Crann-Data/speeduino-hardware/v0.4-mini/Interface boards/48 Pin NA Miata/NA Miata 48 pin_schem.png

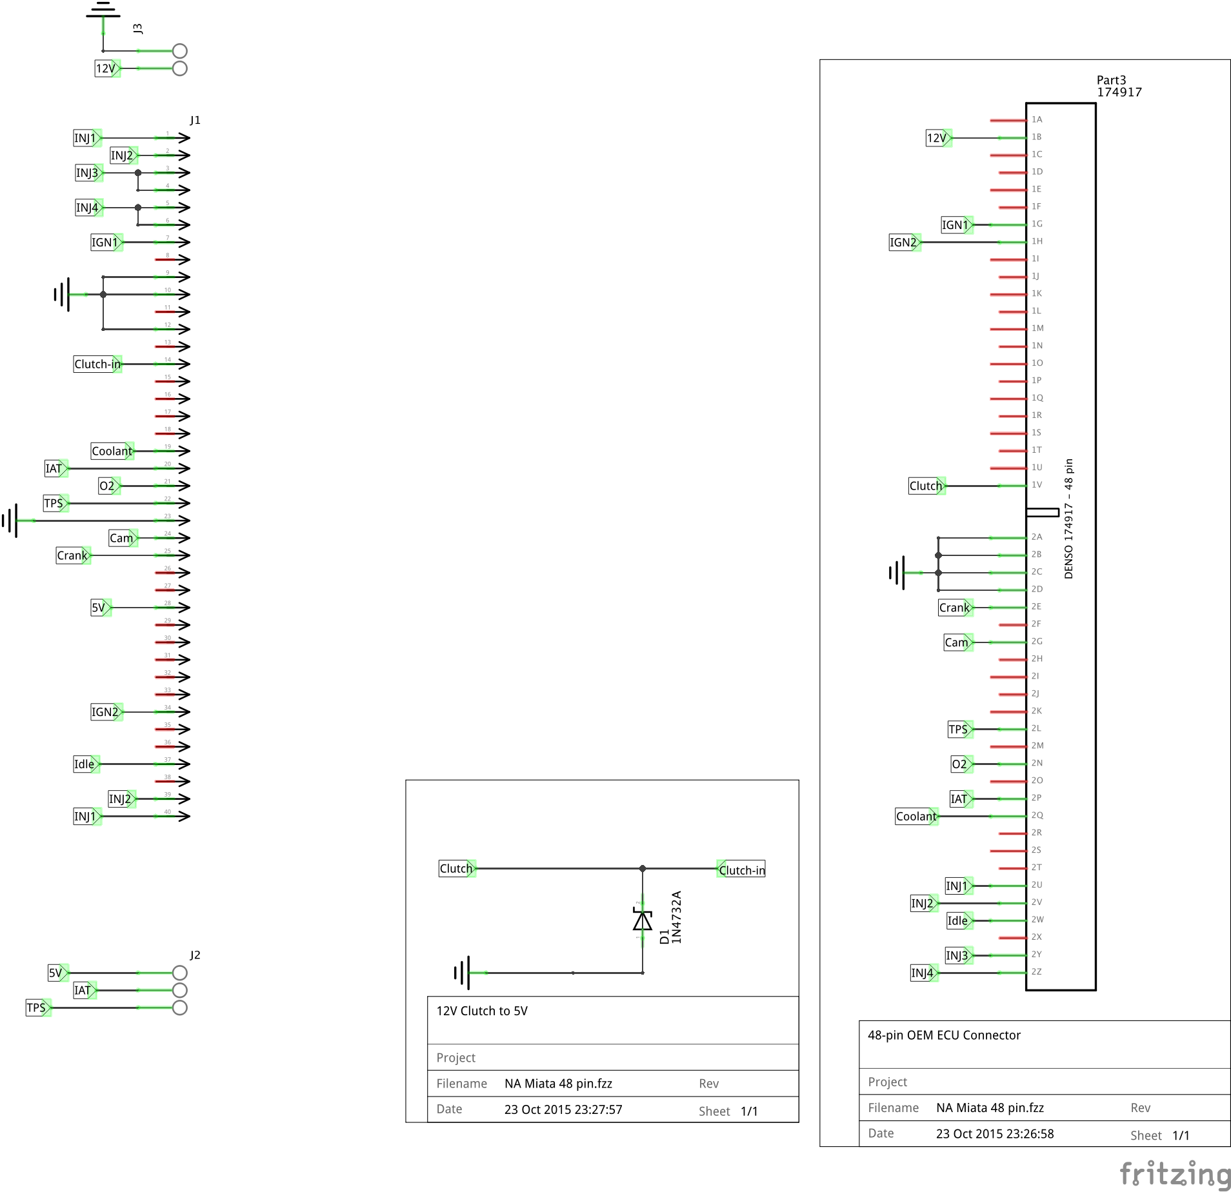
v0.4-mini/Interface boards/48 Pin NA Miata/NA Miata 48 pin_schem.png
