Crann-Data/speeduino-hardware/v0.4-mini/THT/Prior versions/v0.4.3/schematic v0.4.3_schem.png

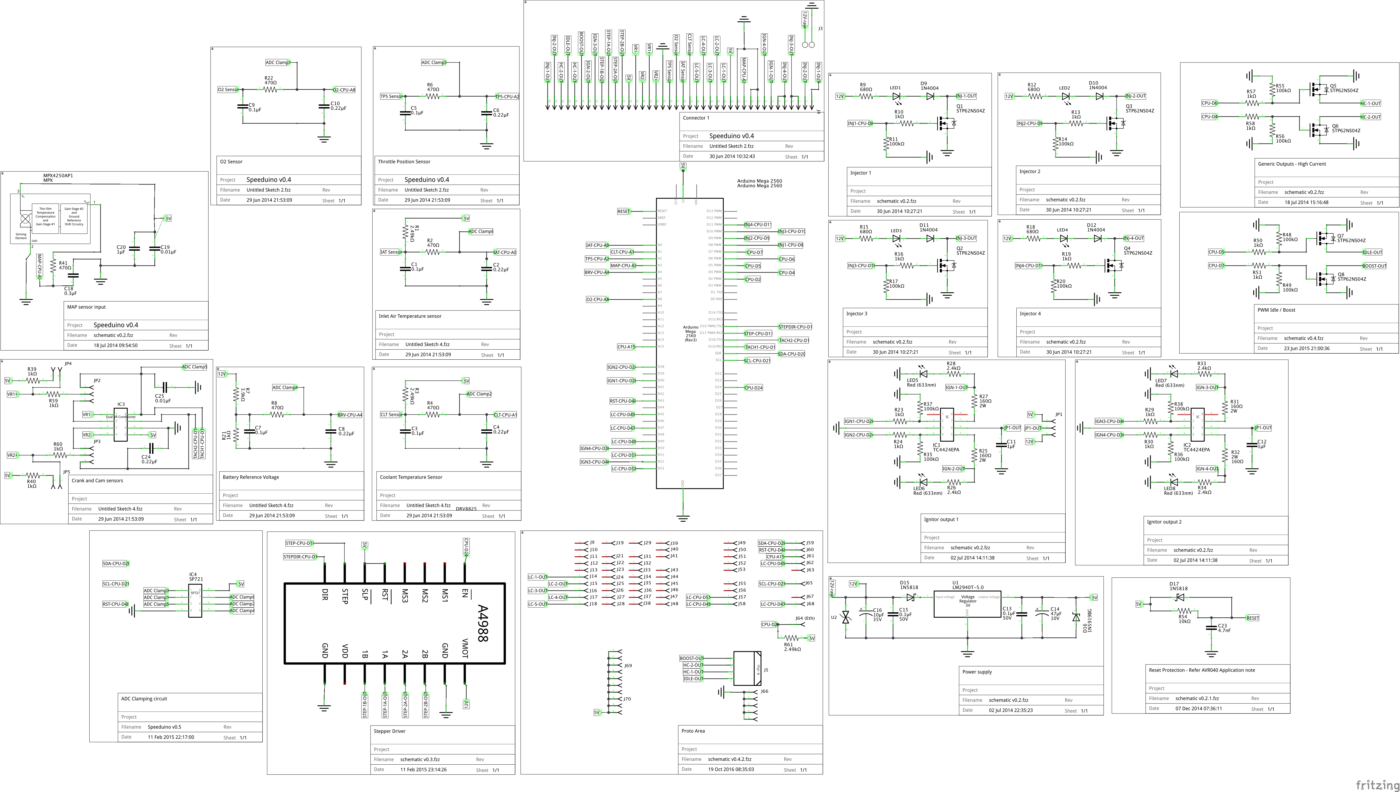
v0.4-mini/THT/Prior versions/v0.4.3/schematic v0.4.3_schem.png
