Crann-Data/speeduino-hardware/v0.4-mini/THT/Prior versions/v0.4.3/Speeduino_v04_notes.png

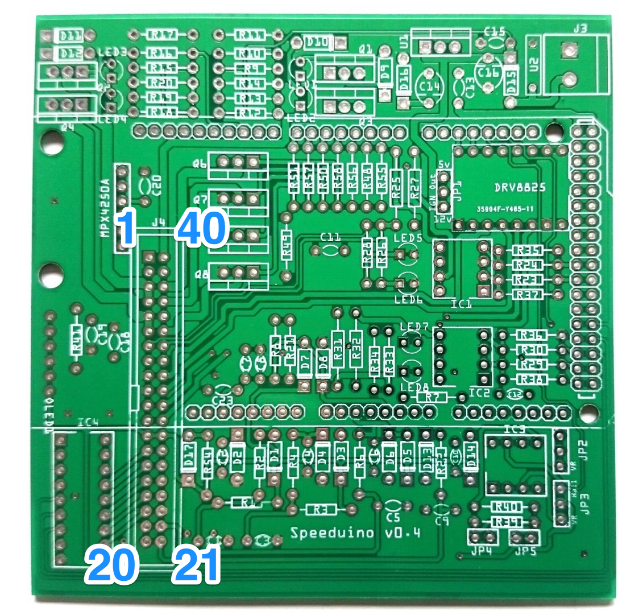
v0.4-mini/THT/Prior versions/v0.4.3/Speeduino_v04_notes.png
