Crann-Data/speeduino-hardware/v0.4-mini/THT/Latest/v0.4.3d BOM.xlsx

 | Speeduino BOM |  |  | v0.4.3d
Reference | Quantity | Value | Manufacturer_Name | Manufacturer_Part_Number | Footprint | URL | Digikey Part Number | Digikey BOM import
A1 | 2 | DRV8825 socket | Sullins | PPTC081LFBN-RC | Module:Pololu_Breakout-16_15.2x20.3mm | https://www.digikey.com.au/products/en?keywords=PPTC081LFBN-RC | S7006-ND | 2,S7006-ND
C1 C15 | 2 | 0.01uF | TDK | FA18X7R1H103KNU06 | Capacitor_THT:C_Disc_D5.0mm_W2.5mm_P2.50mm | https://www.digikey.com.au/product-detail/en/tdk-corporation/FA18X7R1H103KNU06/445-174244-1-ND/5865002 | 445-174244-1-ND | 2,445-174244-1-ND
C17 | 1 | 10uF | Panasonic | EEU-FC1H100L | Capacitor_THT:CP_Radial_D5.0mm_P2.00mm | https://www.digikey.com.au/product-detail/en/panasonic-electronic-components/EEU-FC1H100L/P10316-ND/266325 | P10316-ND | 1,P10316-ND
C19 | 1 | 22uF | TDK | FA22X7R1E226MRU06 | Capacitor_THT:C_Disc_D7.5mm_W5.0mm_P5.00mm |  | 445-180603-1-ND | 1,445-180603-1-ND
C21 | 1 | 47uF | Panasonic | EEU-FC1H470B | Capacitor_THT:CP_Radial_D8.0mm_P5.00mm |  | P19658CT-ND | 1,P19658CT-ND
C3 C4 C9 C10 C11 C16 C18 C20 C22 C23 C24 C28 | 12 | 0.1uF | TDK | FA18X8R1E104KNU06 | Capacitor_THT:C_Disc_D5.0mm_W2.5mm_P2.50mm | https://www.digikey.com.au/product-detail/en/tdk-corporation/FA18X8R1E104KNU06/445-180563-1-ND/9560689 | 445-180563-1-ND | 12,445-180563-1-ND
C2 C25 | 2 | 1uF | TDK | FA18X7R1E105KRU06 | Capacitor_THT:C_Disc_D5.0mm_W2.5mm_P2.50mm | https://www.digikey.com.au/product-detail/en/tdk-corporation/FA18X7R1E105KRU06/445-180543-1-ND/9560669 | 445-180543-1-ND | 2,445-180543-1-ND
C5 C6 C7 C12 C13 C14 | 6 | 0.22uF | TDK | FA18X8R1E224KRU06 | Capacitor_THT:C_Disc_D5.0mm_W2.5mm_P2.50mm | https://www.digikey.com.au/product-detail/en/tdk-corporation/FA18X8R1E224KRU06/445-180564-1-ND/9560690 | 445-180564-1-ND | 6,445-180564-1-ND
C8 C29 | 2 | 470pf | TDK | FA18NP01H471JNU06 | Capacitor_THT:C_Disc_D5.0mm_W2.5mm_P2.50mm | https://www.digikey.com.au/product-detail/en/tdk-corporation/FA18NP01H471JNU06/445-180522-1-ND/9560648 | 445-180522-1-ND | 2,445-180522-1-ND
D5 D6 D11 D12 D13 D16 | 6 | Diode - General purpose | Vishay | 1N914TAP | Diode_THT:D_DO-35_SOD27_P7.62mm_Horizontal | https://www.digikey.com.au/product-detail/en/vishay-general-semiconductor-diodes-division/1N914TAP/1N914TAPGICT-ND/8564478 | 1N914TAPGICT-ND | 6,1N914TAPGICT-ND
D14 | 1 | SB230TA | SMC | SB230TA | Diode_THT:D_DO-41_SOD81_P7.62mm_Horizontal | https://www.digikey.com.au/product-detail/en/smc-diode-solutions/SB230TA/1655-1518-1-ND/6022963 | 1655-1518-1-ND | 1,1655-1518-1-ND
D15 | 1 | D_TVS | Littelfuse | TP6KE47A | Diode_THT:D_DO-15_P12.70mm_Horizontal |  | F6853CT-ND | 1,F6853CT-ND
D1 D2 D3 D4 D7 D8 D9 D10 | 8 | LED | Wurth | 151031SS04000 | LED_THT:LED_D3.0mm | https://www.digikey.com.au/product-detail/en/w%C3%BCrth-elektronik/151031SS04000/732-5005-ND/4489979 | 732-5005-ND | 8,732-5005-ND
F1 F2 | 2 | Polyfuse | Bel Fuse | 0ZRP0050FF1E | Fuse:Fuse_BelFuse_0ZRE0055FF_L14.0mm_W4.1mm | https://www.digikey.com.au/product-detail/en/bel-fuse-inc/0ZRP0050FF1E/507-2403-ND/9468252 | 507-2403-ND | 2,507-2403-ND
IC3 | 2 | Trig Cond Socket | Sullins Connector Solutions | PPTC041LFBN-RC | Package_DIP:DIP-8_W7.62mm_Socket |  | S7002-ND | 2,S7002-ND
J4 | 1 | Conn_02x20_Counter_Clockwise | Sullins | SBH11-PBPC-D20-ST-BK | Connector_IDC:IDC-Header_2x20_P2.54mm_Vertical | https://www.digikey.com.au/product-detail/en/sullins-connector-solutions/SBH11-PBPC-D20-ST-BK/S9175-ND/1990068 | S9175-ND | 1,S9175-ND
Q1 Q2 Q3 Q4 | 4 | N-Channel MOSFET | ST | STP62NS04Z | Package_TO_SOT_THT:TO-220-3_Horizontal_TabDown |  | 497-5896-5-ND | 4,497-5896-5-ND
Q5 Q6 | 2 | Q_NMOS_GDSD | Vishay | IRLD024PBF | Package_DIP:Vishay_HVM-DIP-3_W7.62mm | https://www.digikey.com.au/product-detail/en/vishay-siliconix/IRLD024PBF/IRLD024PBF-ND/812492 | IRLD024PBF-ND | 2,IRLD024PBF-ND
R1 R2 R3 R4 R13 R14 R15 R16 R19 R20 R28 R43 | 12 | 100k | Vishay | MBA02040C1003FCT00 | Resistor_THT:R_Axial_DIN0204_L3.6mm_D1.6mm_P5.08mm_Horizontal | https://www.digikey.com.au/product-detail/en/vishay-beyschlag-draloric-bc-components/MBA02040C1003FCT00/BC3240CT-ND/6138743 | BC3240CT-ND | 12,BC3240CT-ND
R9 R10 R11 R12 R23 R24 R25 R26 R33 | 9 | 2.4k | Vishay | MBA02040C2401FC100 | Resistor_THT:R_Axial_DIN0204_L3.6mm_D1.6mm_P5.08mm_Horizontal | https://www.digikey.com.au/product-detail/en/vishay-beyschlag-draloric-bc-components/MBA02040C2401FC100/BC3483CT-ND/7350913 | BC3483CT-ND | 9,BC3483CT-ND
R30 | 1 | 3.9k | Vishay | MBA02040C3901FCT00 | Resistor_THT:R_Axial_DIN0204_L3.6mm_D1.6mm_P5.08mm_Horizontal | https://www.digikey.com.au/product-detail/en/vishay-beyschlag-draloric-bc-components/MBA02040C3901FCT00/BC3272CT-ND/6138775 | BC3272CT-ND | 1,BC3272CT-ND
R31 R32 R34 R38 R39 R40 R55 R62 R63 | 9 | 470R | Vishay | MBA02040C4700FRP00 | Resistor_THT:R_Axial_DIN0204_L3.6mm_D1.6mm_P5.08mm_Horizontal | https://www.digikey.com.au/product-detail/en/vishay-beyschlag-draloric-bc-components/MBA02040C4700FRP00/BC3516CT-ND/7350946 | BC3516CT-ND | 9,BC3516CT-ND
R35 R36 | 2 | 2.49k | Vishay | MBA02040C2491FRP00 | Resistor_THT:R_Axial_DIN0204_L3.6mm_D1.6mm_P5.08mm_Horizontal | https://www.digikey.com.au/product-detail/en/vishay-beyschlag-draloric-bc-components/MBA02040C2491FRP00/BC2-49KXCT-ND/336807 | BC2.49KXCT-ND | 2,BC2.49KXCT-ND
R27 R45 | 2 | 10k | Vishay | MBA02040C1002FRP00 | Resistor_THT:R_Axial_DIN0204_L3.6mm_D1.6mm_P5.08mm_Horizontal | https://www.digikey.com.au/product-detail/en/vishay-beyschlag-draloric-bc-components/MBA02040C1002FRP00/BC10-0KXCT-ND/336866 | BC10.0KXCT-ND | 2,BC10.0KXCT-ND
R46 | 1 | 120R | Vishay | MBA02040C1200FC100 | Resistor_THT:R_Axial_DIN0204_L3.6mm_D1.6mm_P5.08mm_Horizontal |  | BC3453CT-ND | 1,BC3453CT-ND
R5 R6 R7 R8 R17 R18 R21 R22 R29 R37 R41 R42 R44 R47 R53 R54 | 16 | 1k | Vishay | MBA02040C1001FRP00 | Resistor_THT:R_Axial_DIN0204_L3.6mm_D1.6mm_P5.08mm_Horizontal |  | BC1.00KXCT-ND | 16,BC1.00KXCT-ND
R52 | 1 | 2k | Vishay | MBA02040C2001FCT00 | Resistor_THT:R_Axial_DIN0204_L3.6mm_D1.6mm_P5.08mm_Horizontal | https://www.digikey.com.au/product-detail/en/vishay-beyschlag-draloric-bc-components/MBA02040C2001FCT00/BC3254CT-ND/6138757 | BC3254CT-ND | 1,BC3254CT-ND
U1 U3 | 2 | SP721 | Littelfuse | SP721APP | Package_DIP:DIP-8_W7.62mm |  | F2720-ND | 2,F2720-ND
U2 U4 | 2 | TC4424A | Microchip | TC4424AVPA | Package_DIP:DIP-8_W7.62mm_Socket | https://www.digikey.com.au/product-detail/en/microchip-technology/TC4424AVPA/TC4424AVPA-ND/1098910 | TC4424AVPA-ND | 2,TC4424AVPA-ND
U5 | 1 | MPX4250 | NXP | MPX4250AP | Misc:MPX4250 | https://www.digikey.com.au/product-detail/en/nxp-usa-inc/MPX4250AP/MPX4250AP-ND/464053 | MPX4250AP-ND | 1,MPX4250AP-ND
U6 | 1 | ULN2003 | TI | ULN2003AIN‎ | Package_DIP:DIP-16_W7.62mm | https://www.digikey.com.au/product-detail/en/texas-instruments/ULN2003AIN/296-16971-5-ND/653041 | 296-16971-5-ND | 1,296-16971-5-ND
U8 | 1 | LM2940S-5.0 | ON Semi | NCV7805BTG | Package_TO_SOT_THT:TO-220-3_Horizontal_TabDown | https://www.digikey.com.au/product-detail/en/on-semiconductor/NCV7805BTG/NCV7805BTGOS-ND/921437 | NCV7805BTGOS-ND | 1,NCV7805BTGOS-ND
