Crann-Data/speeduino-hardware/v0.4-mini/THT/Prior versions/v0.4.3/v0.4.3_bom.xlsx

QTY Full | Board Reference Full | Value | Type | Information | Included | Manufacturer | Model# | Digikey P/N | Mouser P/N | Digikey Price (USD) | Mouser Price (USD) | CTM Full Digikey | CTM Full Mouser | CTM 2 Ch Digikey | CTM 2 Ch Mouser | Note | Full Digikey import | 2Ch Digikey import | General Description | Mouser Full
 |  |  |  |  |  |  |  |  |  |  |  |  |  |  |  |  |  |  | x
1 | C16 | 10uF | CAP TANT 10UF 35V 10% RADIAL | Tantalum |  | Kemet | T356G106K035AT | 399-3654-ND (http://www.digikey.com/product-detail/en/TAP106K035SCS/478-1842-ND/563945) | 80-T356G106K035AT | $1.70 | $1.70 | $1.70 | $1.70 | $1.70 | $1.70 |  | 1,399-3654-ND | 1,399-3654-ND | Capacitor - 1x 10uF | 80-T356G106K035AT|1 | T356G106K035AT 1
6 | C2,C4,C6,C8,C10,C24 | 0.22uF | CAP CER 0.22UF 50V 10% RADIAL | X7R |  | Kemet | K224K20X7RF5UH5 | BC2678CT-ND | 594-K224K20X7RF5UH5 | $0.66 | $0.66 | $3.96 | $3.96 | $3.96 | $3.96 |  | 6,BC2678CT-ND | 6,BC2678CT-ND | Capacitor - 6x 0.22uF | 594-K224K20X7RF5UH5|6 | K224K20X7RF5UH5 6
7 | C1,C3,C5,C7,C9,C13,C15 | 0.1uF / 100nF | CAP CER 0.1UF 50V 20% RADIAL | X7R |  | Vishay | K104K15X7RF53H5 | BC3323-ND | 80-C322C104M5R-TR | $0.36 | $0.32 | $2.52 | $2.24 | $2.52 | $2.24 |  | 7,BC3323-ND | 7,BC3323-ND | Capacitor - 7x 0.1uF / 100nF | 80-C322C104M5R-TR|7 | K104K15X7RF53H5 7
1 | C14 | 47uF | CAP TANT 47UF 6.3V 10% RADIAL | Tantalum |  | Kemet | T356F476K006AT | 399-3652-ND (http://search.digikey.com/us/en/products/TAP476K010SCS/478-1910-ND/564013) | 80-T356F476K6AT | $1.57 | $1.57 | $1.57 | $1.57 | $1.57 | $1.57 |  | 1,399-3652-ND | 1,399-3652-ND | Capacitor - 1x 47uF | 80-T356F476K6AT|1 | T356F476K006AT 1
1 | C18 | 0.33uF | CAP CER 0.33UF 50V 10% RADIAL | X7R |  | AVX Corporation | AR215F334K4R | 478-5120-ND (http://search.digikey.com/us/en/products/FK14X7R1H334K/445-5312-ND/2256792) | 581-AR215F334K4R | $0.62 | $0.43 | $0.62 | $0.43 | $0.62 | $0.43 |  | 1,478-5120-ND | 1,478-5120-ND | Capacitor - 1x 0.33uF | 581-AR215F334K4R|1 | AR215F334K4R 1
2 | C19,C25 | 0.01uF | CAP CER 10000PF 50V 10% RADIAL | X7R |  | Kemet | C317C103K5R5TA | 399-4206-ND (http://www.digikey.com/product-detail/en/C315C103K5R5TA/399-4148-ND/817924) | 80-C317C103K5R | $0.24 | $0.24 | $0.48 | $0.48 | $0.48 | $0.48 |  | 2,399-4206-ND | 2,399-4206-ND | Capacitor - 2x 0.01uF | 80-C317C103K5R|2 | C317C103K5R5TA 2
3 | C11,C12,C20 | 1uF | CAP CER 1UF 50V 20% RADIAL | X7R |  | Kemet | C330C105M5U5TA | 399-4390-ND | 80-C330C105M5U | $0.66 | $0.66 | $1.98 | $1.98 | $1.32 | $1.32 |  | 3,399-4390-ND | 2,399-4390-ND | Capacitor - 3x 1uF | 80-C330C105M5U|3 | C330C105M5U5TA 3
1 | C23 | 4.7nF | CAP CER 4700PF 100V 10% RADIAL | X7R |  | Kemet | C317C472K1R5TA | 399-4243-ND | 80-C317C472K1R | $0.25 | $0.25 | $0.25 | $0.25 | $0.25 | $0.25 |  | 1,399-4243-ND | 1,399-4243-ND | Capacitor - 1x 4.7nF | 80-C317C472K1R|1 | C317C472K1R5TA 1
1 | D16 | 1N5919BG Zener | DIODE ZENER 5.6V 3W AXIAL | DO-41 |  | ON Semiconductor | 1N5919BG | 1N5919BGOS-ND | 863-1N5919BRLG | $0.34 | $0.43 | $0.34 | $0.43 | $0.34 | $0.43 |  | 1,1N5919BGOS-ND | 1,1N5919BGOS-ND | Diode - 1x 1N5919BG Zener | 863-1N5919BRLG|1 | 1N5919BG 1
2 | D15,D17 | 1N5818-TP Schottky | DIODE SCHOTTKY 1A 30V DO41 | DO-41 |  | Micro Commercial Co | 1N5818-TP | 1N5818-TPCT-ND (http://search.digikey.com/us/en/products/1N5818-TP/1N5818-TPCT-ND/950587) | 833-1N5818-TP | $0.39 | $0.39 | $0.78 | $0.78 | $0.78 | $0.78 |  | 2,1N5818-TPCT-ND | 2,1N5818-TPCT-ND | Diode - 2x 1N5818-TP Schottky | 833-1N5818-TP|2 | 1N5818-TP 2
8 | LED1,LED2,LED3,LED4,LED5,LED6,LED7,LED8 | LED-Red | LED SS 3MM 625NM RED DIFF | 5mm-LED |  |  | LTL-4221N | 160-1139-ND | 859-LTL-4221N | $0.47 | $0.10 | $3.76 | $0.80 | $1.88 | $0.40 |  | 8,160-1139-ND | 4,160-1139-ND | Diode - 8x LED-Red | 859-LTL-4221N|8 | LTL-4221N 8
4 | D9,D10,D11,D12 | 1N4004 | DIODE GEN PURPOSE 400V 1A DO41 | DO-41 |  | Micro Commercial Co | 1N4004-TP | 1N4004-TPMSCT-ND | 833-1N4004-TP | $0.11 | $0.11 | $0.44 | $0.44 | $0.22 | $0.22 |  | 4,1N4004-TPMSCT-ND | 2,1N4004-TPMSCT-ND | Diode - 4x 1N4004 | 833-1N4004-TP|4 | 1N4004-TP 4
 |  |  |  |  |  |  |  |  |  |  |  |  |  |  |  |  |  |  | x
1 | U2 | Surge Protection | VARISTOR 22V 3KA DISC 14MM | Disc 14mm |  | Bournes Inc | V14E14AUTO | F6389-ND |  | $0.72 | $0.72 | $0.72 | $0.72 | $0.72 | $0.72 |  | 1,F6389-ND | 1,F6389-ND | 1x Surge Protection |  | V14E14AUTO 1
 |  |  |  |  |  |  |  |  |  |  |  |  |  | $0.00 | $0.00 |  |  |  | x
1 | J3 | Dual Terminal Block | TERMINAL BLOCK 5MM VERT 2POS PCB |  |  | On Shore Technology Inc | OSTTA020161 | ED2561-ND | 571-2828362 | 0.402 | 0.51 | $0.40 | $0.51 | $0.40 | $0.51 | Quite expensive from digikey, cheaper elsewhere | 1,ED2561-ND | 1,ED2561-ND | 1x Dual Terminal Block | 571-2828362|1 | OSTTA020161 1
5 | Jumpers for male pins | Jumper | SHUNT JUMPER .1" BLACK GOLD |  |  |  | 969102-0000-DA | 3M9580-ND | 517-9691020000DA | $0.10 | $0.10 | $0.50 | $0.50 | $0.50 | $0.50 |  | 5,3M9580-ND | 5,3M9580-ND | 5x Jumper | 517-9691020000DA|5 | 969102-0000-DA 5
4 | Male pins | 40 POS 0.100 Pin Header | CONN HEADER .100" SNGL STR 40POS |  |  | Sullins Connector Solutions | PREC040SAAN-RC.. | S1012EC-40-ND | 571-41037410 | $0.56 | $2.95 | $2.24 | $11.80 | $2.24 | $11.80 | Mouser price is crazy | 4,S1012EC-40-ND | 4,S1012EC-40-ND | 4x 40 POS 0.100 Pin Header | 571-41037410|4 | PREC040SAAN-RC.. 4
1 | J4 | Rectangular Connectors - Headers, Male Pins | IDC BOX HEADER .100" 40POS |  |  | CNC Tech | 3020-40-0100-00 | 1175-1614-ND | 571-5103308-8 | $1.13 | $2.00 | $1.13 | $2.00 | $1.13 | $2.00 |  | 1,1175-1614-ND | 1,1175-1614-ND | 1x Rectangular Connectors - Headers, Male Pins | 571-5103308-8|1 | 3020-40-0100-00 1
 |  |  |  |  |  |  |  |  |  |  |  |  |  |  |  |  |  |  | x
8 | Q1,Q2,Q3,Q4,Q5,Q6,Q7,Q8 | 62A MOSFET N-CH | MOSFET N-CH 33V TO-220 | TO-220 |  | STMicroelectronics | STP75NS04Z | 497-5981-5-ND | 511-STP62NS04Z | $1.51 | $1.51 | $12.08 | $12.08 | $9.06 | $9.06 |  | 8,497-5981-5-ND | 6,497-5981-5-ND | 8x 62A MOSFET N-CH | 511-STP62NS04Z|8 | STP75NS04Z 8
1 | R54 | 10k | RES 10.0K OHM 1/4W 1% METAL FILM |  |  | Yageo | MFR-25FBF52-10K | 10.0KXBK-ND (http://search.digikey.com/us/en/products/MFR-25FBF-10K0/10.0KXBK-ND/13219) | 71-RN60D-F-10K | $0.08 | $0.11 | $0.08 | $0.11 | $0.08 | $0.11 |  | 1,10.0KXBK-ND | 1,10.0KXBK-ND | Resistor - 1x 10k | 71-RN60D-F-10K|1 | MFR-25FBF52-10K 1
17 | R10,R13,R16,R19,R21,R23,R24,R29,R30,R39,R40,R50,R51,R57,R58,R59,R60 | 1k | RES 1.00K OHM 1/4W 1% METAL FILM |  |  | Yageo | MFR-25FBF52-1K | 1.00KXBK-ND | 71-RN60D-F-1.0K | $0.06 | $0.11 | $1.02 | $1.87 | $0.78 | $1.43 |  | 17,1.00KXBK-ND | 13,1.00KXBK-ND | Resistor - 17x 1k | 71-RN60D-F-1.0K|17 | MFR-25FBF52-1K 17
4 | R9,R12,R15,R18 | 680 | RES 680 OHM 0.6W 1% AXIAL |  |  | TE Connectivity | 1622545-1 | A105963CT-ND | 279-LR1F680R | $0.22 | $0.15 | $0.88 | $0.60 | $0.44 | $0.30 | LED current limiting resistors | 4,A105963CT-ND | 2,A105963CT-ND | Resistor - 4x 680 | 279-LR1F680R|4 | 1622545-1 4
6 | R2,R4,R6,R8,R22,R41 | 470 | RES METAL FILM 1/4W 470 OHM 1% AXIAL |  |  | Stackpole Electronics Inc | RNF14FTD470R | RNF14FTD470RCT-ND | 279-LR1F470R | $0.11 | $0.15 | $0.66 | $0.90 | $0.66 | $0.90 |  | 6,RNF14FTD470RCT-ND | 6,RNF14FTD470RCT-ND | Resistor - 6x 470 | 279-LR1F470R|6 | RNF14FTD470R 6
7 | R1,R3,R26,R28,R33,R34,R61 | 1% 2.49k | 2.49k Ohm ±1% 0.25W, 1/4W Through Hole Resistor Axial Metal Film | For GM Sensors |  | Yageo | MFR-25FBF52-2K49 | 2.49KXBK-ND (http://search.digikey.com/us/en/products/RC55Y-2K49BI/985-1047-1-ND/2401912) | 603-MFR-25FBF52-2K49 | $0.14 | $0.16 | $0.98 | $1.12 | $0.70 | $0.80 |  | 7,2.49KXBK-ND | 5,2.49KXBK-ND | Resistor - 7x 1% 2.49k | 603-MFR-25FBF52-2K49|7 | MFR-25FBF52-2K49 7
1 | R7 | 0.1% 3.9k | RES 3.9K OHM 1/4W 0.1% METAL FILM AXL |  |  | Yageo | MFP-25BRD52-3K9 | 3.9KADCT-ND (http://search.digikey.com/us/en/products/MFP-25BRD52-3K9/3.9KADCT-ND/2059137) | 279-H83K9BDA | $0.46 | $1.10 | $0.46 | $1.10 | $0.46 | $1.10 | Battery reference (Voltage divider) | 1,3.9KADCT-ND | 1,3.9KADCT-ND | Resistor - 1x 0.1% 3.9k | 279-H83K9BDA|1 | MFP-25BRD52-3K9 1
12 | R11,R14,R17,R20,R35,R36,R37,R38,R48,R49,R55,R56 | 100k | RES 100K OHM 1/4W 1% METAL FILM |  |  | Yageo | MFR-25FBF52-100K | 100KXBK-ND (http://search.digikey.com/us/en/products/MFR-25FBF-100K/100KXBK-ND/13473) | 603-FMF-25FTF52100K | $0.10 | $0.10 | $1.20 | $1.20 | $0.80 | $0.80 |  | 12,100KXBK-ND | 8,100KXBK-ND | Resistor - 12x 100k | 603-FMF-25FTF52100K|12 | MFR-25FBF52-100K 12
4 | R25,R27,R31,R32 | 160 | RES 10 OHM 2W 5% AXIAL |  |  | Yageo | FMP200JR-52-10R | 10ZCT-ND |  | $0.27 | $0.23 | $1.08 | $0.92 | $0.54 | $0.46 |  | 4,10ZCT-ND | 2,10ZCT-ND | Resistor - 4x 160 |  | FMP200JR-52-10R 4
1 | U1 | LM2940T-5.0/NOPB | IC REGULATOR LDO LM2940-5.0 1A TO220 | TO-220 |  | Texas Instruments | LM2940T-5.0/NOPB | LM2940T-5.0/NOPB | 926-LM2940T-5.0/NOPB | $1.68 | $1.67 | $1.68 | $1.67 | $1.68 | $1.67 |  | 1,LM2940T-5.0/NOPB | 1,LM2940T-5.0/NOPB | 1x LM2940T-5.0/NOPB | 926-LM2940T-5.0/NOPB|1 | LM2940T-5.0/NOPB 1
1 | MPX4250A | 1-Bar MAP sensor | SENSOR ABS PRESS 36.3 PSI MAX | 6-SIP |  | Freescale Semiconductor | MPX4250AP | MPX4250AP-ND (http://www.digikey.com.au/product-detail/en/MPX4250AP/MPX4250AP-ND/464053) | 841-MPX4250AP | $15.41 | $15.37 | $15.41 | $15.37 | $15.41 | $15.37 |  | 1,MPX4250AP-ND | 1,MPX4250AP-ND | 1x 1-Bar MAP sensor | 841-MPX4250AP|1 | MPX4250AP 1
2 | IC1,IC2 | TC4424EPA | IC MOSFET DVR 3A DUAL HS 8-DIP | 8-DIP |  | Microchip Technology | TC4424EPA | TC4424EPA-ND | 579-TC4424EPA | $2.92 | $2.92 | $5.84 | $5.84 | $2.92 | $2.92 |  | 2,TC4424EPA-ND | 1,TC4424EPA-ND | 2x TC4424EPA | 579-TC4424EPA|2 | TC4424EPA 2
1 | IC4 | SP721APP | TVS ARRAY ESD 6 INPUT 30V 8-DIP | 8-DIP |  | Littelfuse Inc. | SP721APP | F2720-ND | 576-SP721APP | $2.40 | $2.40 | $2.40 | $2.40 | $2.40 | $2.40 |  | 1,F2720-ND | 1,F2720-ND | 1x SP721APP | 576-SP721APP|1 | SP721APP 1
3 | IC SOCKET MACH PIN ST 8POS TIN | IC Socket |  |  |  |  | AR08-HZL-TT-R | AE10011-ND | 571-1-2199298-2 | $0.50 | $0.10 | $1.50 | $0.30 | $1.00 | $0.20 |  | 3,AE10011-ND | 2,AE10011-ND | 3x IC Socket | 571-1-2199298-2|3 | AR08-HZL-TT-R 3
1 | Case |  |  |  |  | Hammand Manufacturing | 1455N1202 | HM975-ND | 546-1455N1202 | $15.33 | $15.33 | $15.33 | $15.33 | $15.33 | $15.33 |  | 1,HM975-ND | 1,HM975-ND |  | 546-1455N1202|1
 | Printed Circuit Board
1 | Speeduino v0.4 | Estimate ONLY |  |  |  | N/A | N/A |  |  | $15.00 | $15.00 | $15.00 | $15.00
1 | Arduino Mega |  |  |  |  |  |  | 1050-1018-ND |  | 61.65 |  |  |  |  |  | Note that these can be found a lot cheaper elsewhere (~$25)
 |  |  |  |  |  |  | Total of Materials:Cost to Manufacture |  |  | US Dollars |  | $98.99 | $106.40 | $72.89 | $82.16 | Not including shipping or sales tax
