Crann-Data/speeduino-hardware/v0.4-mini/THT/Latest/v0.4.3d.pdf

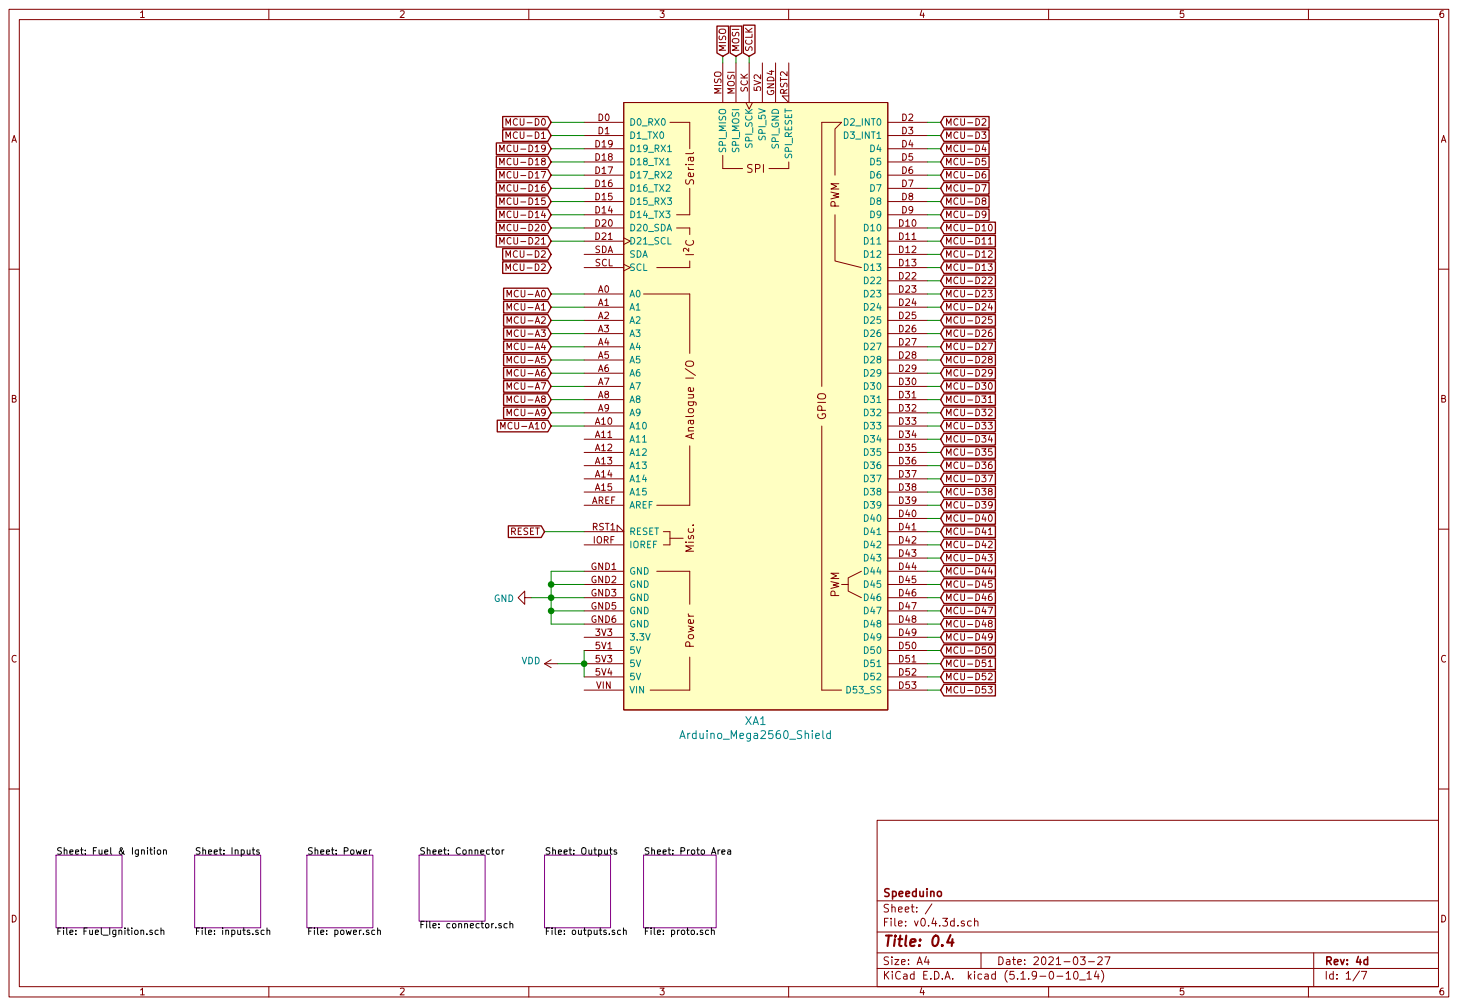
[picture p6: page 1]

File: outputs.sch GND

Sheet: Proto Area File: proto.sch

File: v0.4.3d.sch Sheet: / Speeduino

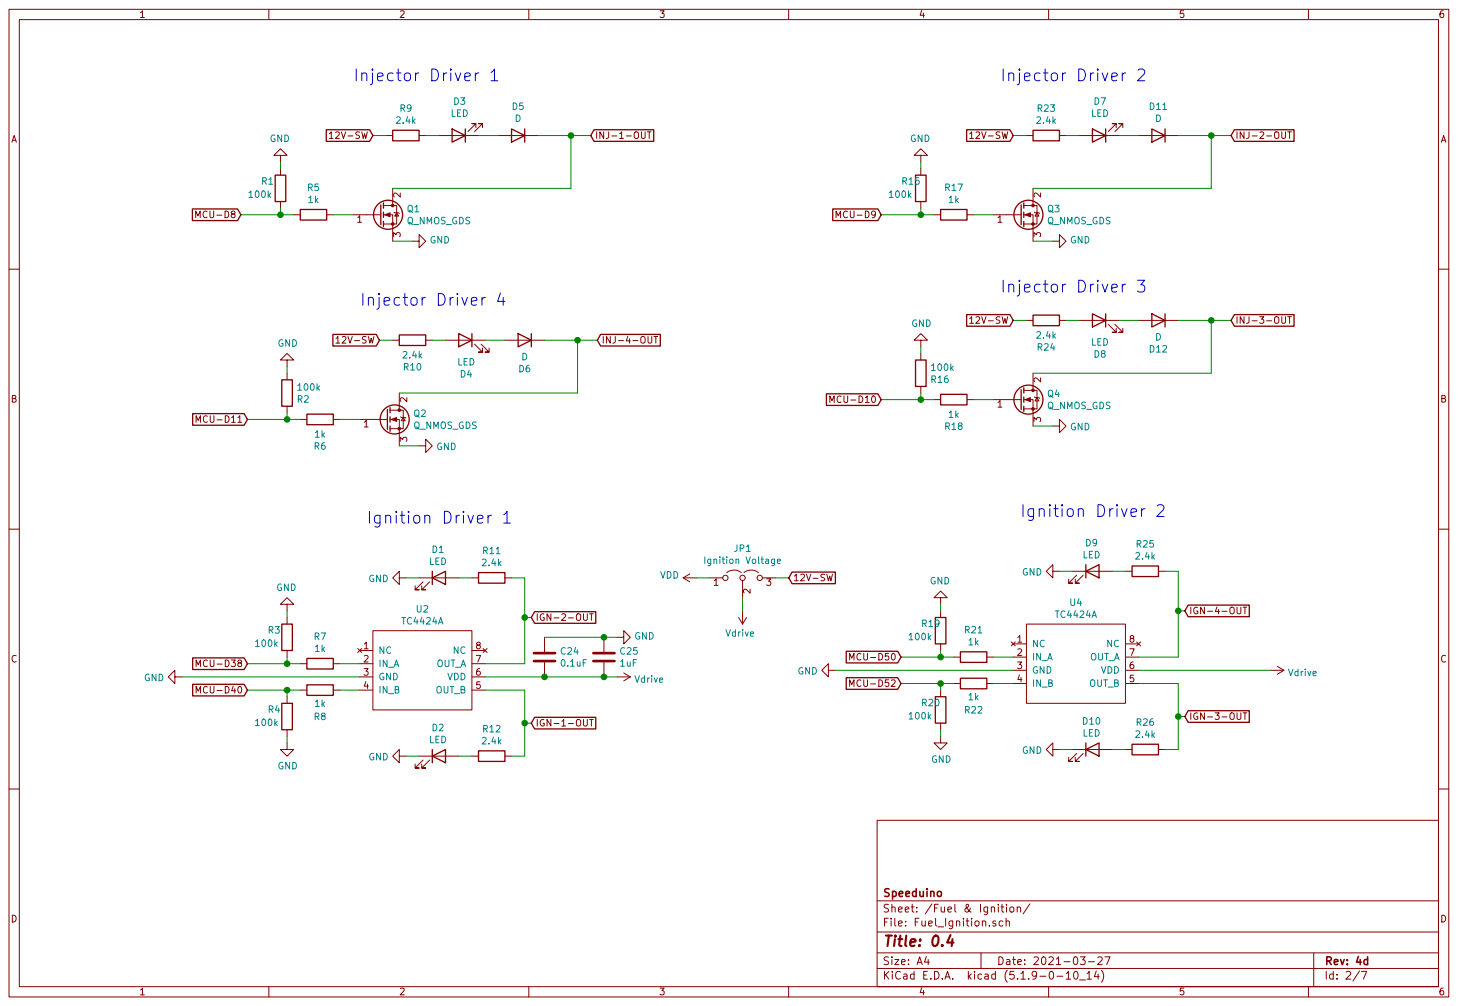
[picture p7: page 2]

Ignition Driver 2 Ignition Driver 1

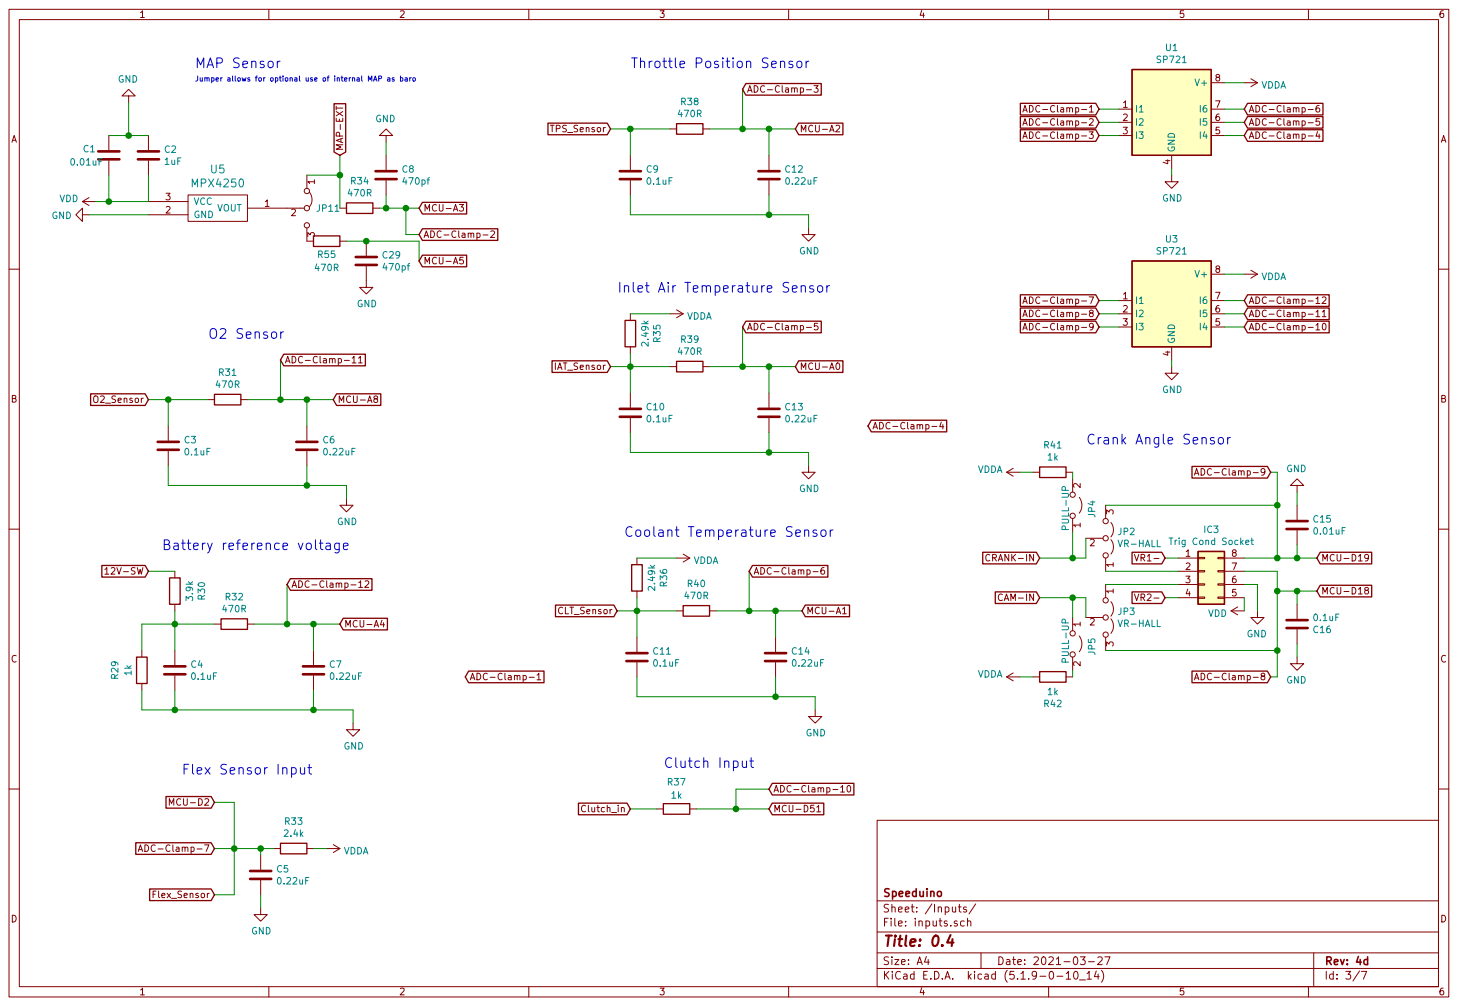
[picture p8: page 3]

Jumper allows for optional use of internal MAP as baro O2 Sensor

Inlet Air Temperature Sensor

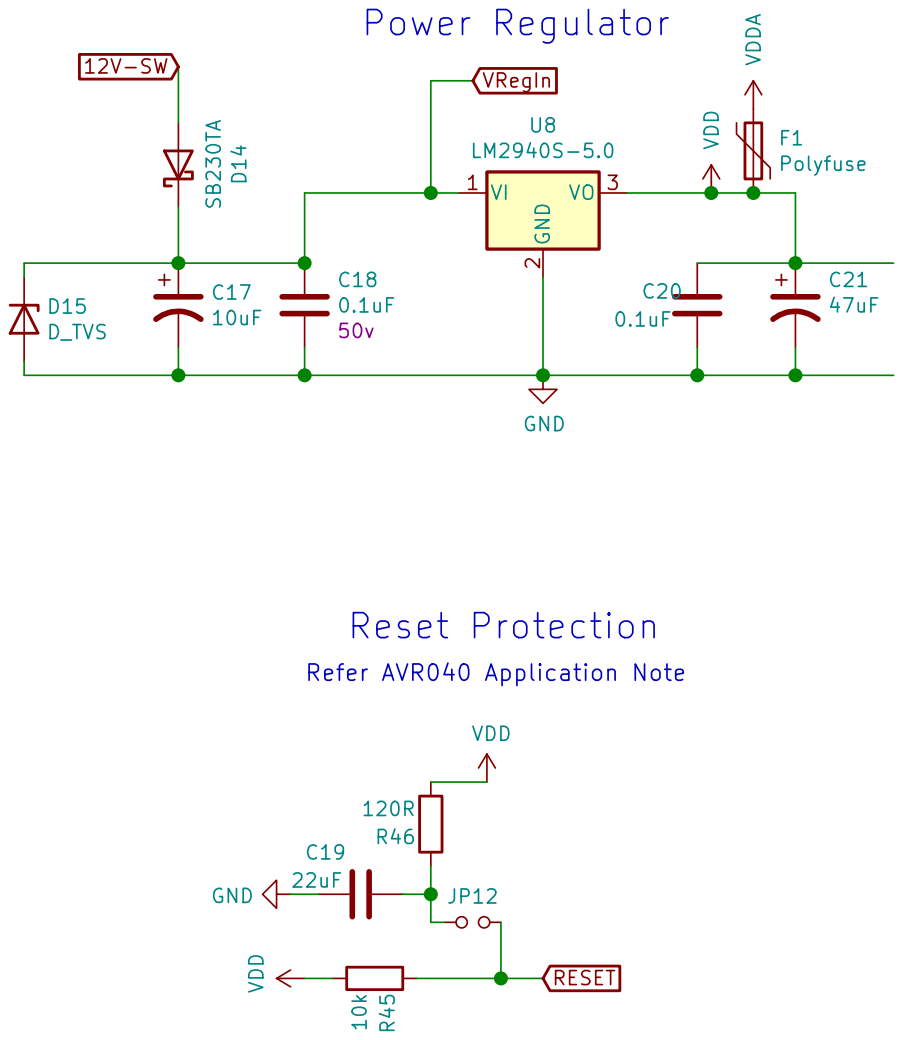
[picture p9: page 4]

File: power.sch Sheet: /Power/ Speeduino

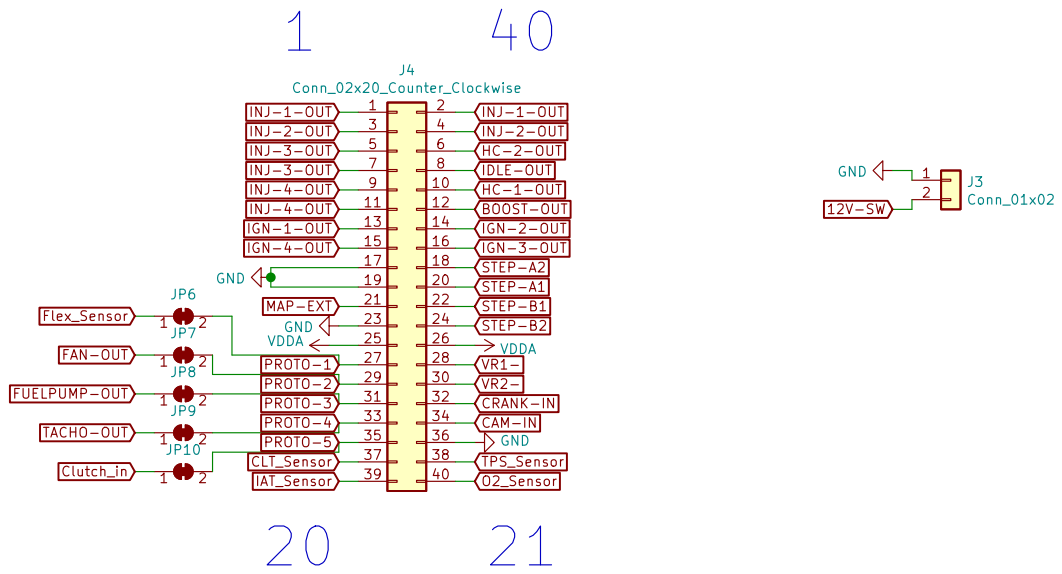
[picture p10: page 5]

IDLE-OUT PROTO-1 PROTO-2 PROTO-3 PROTO-4 PROTO-5
INJ-4-OUT

File: connector.sch Sheet: /Connector/ Speeduino GND

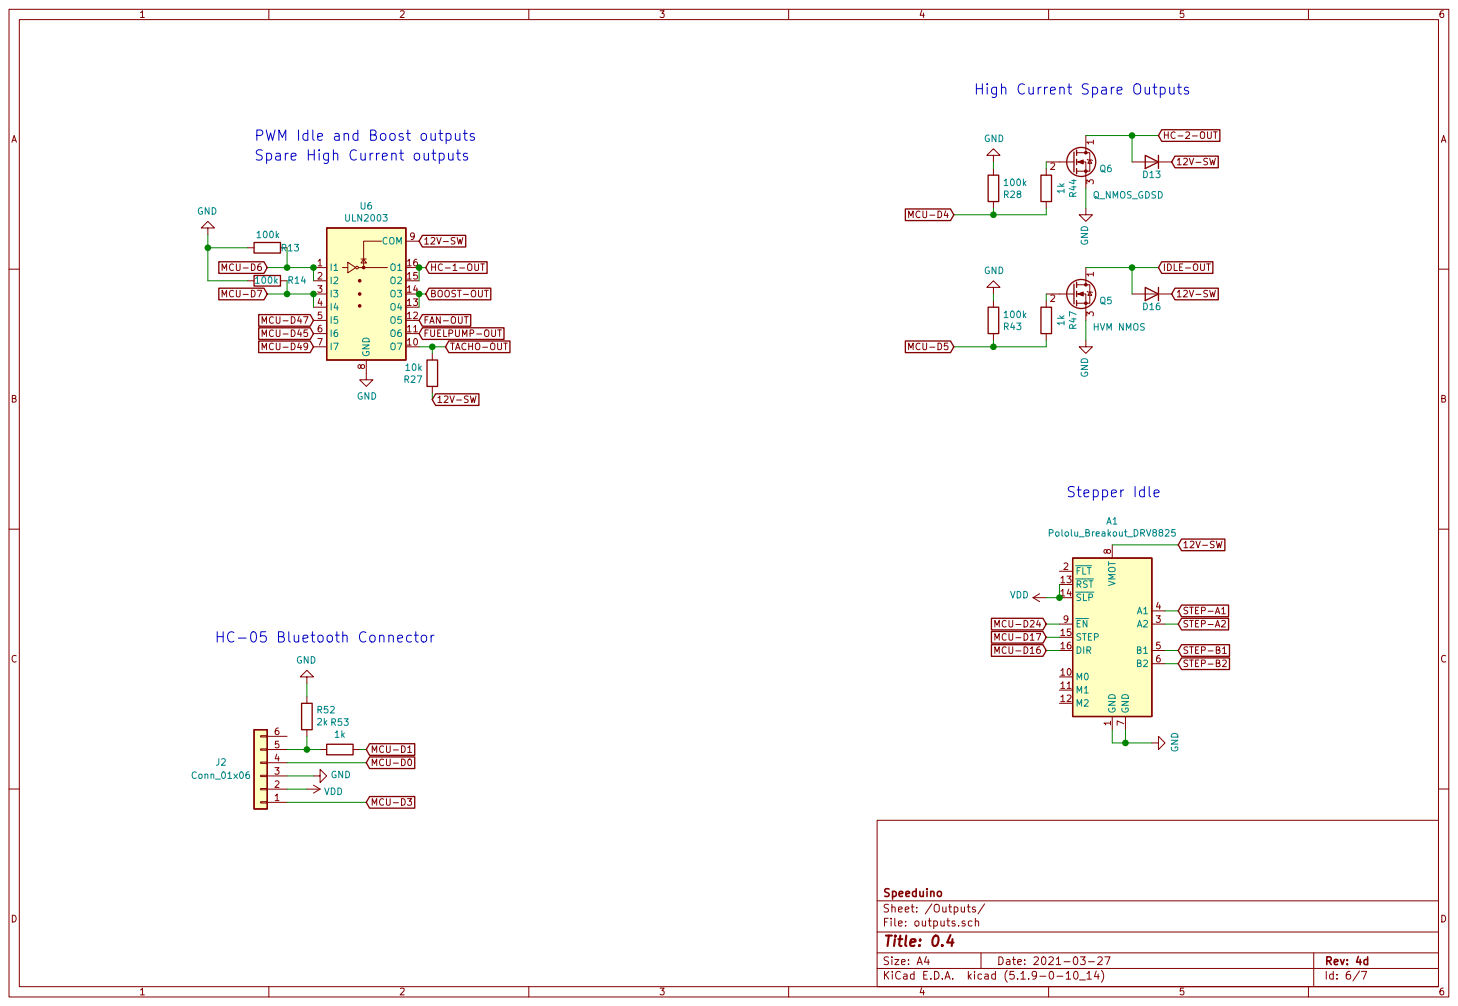
[picture p11: page 6]

High Current Spare Outputs

PWM Idle and Boost outputs

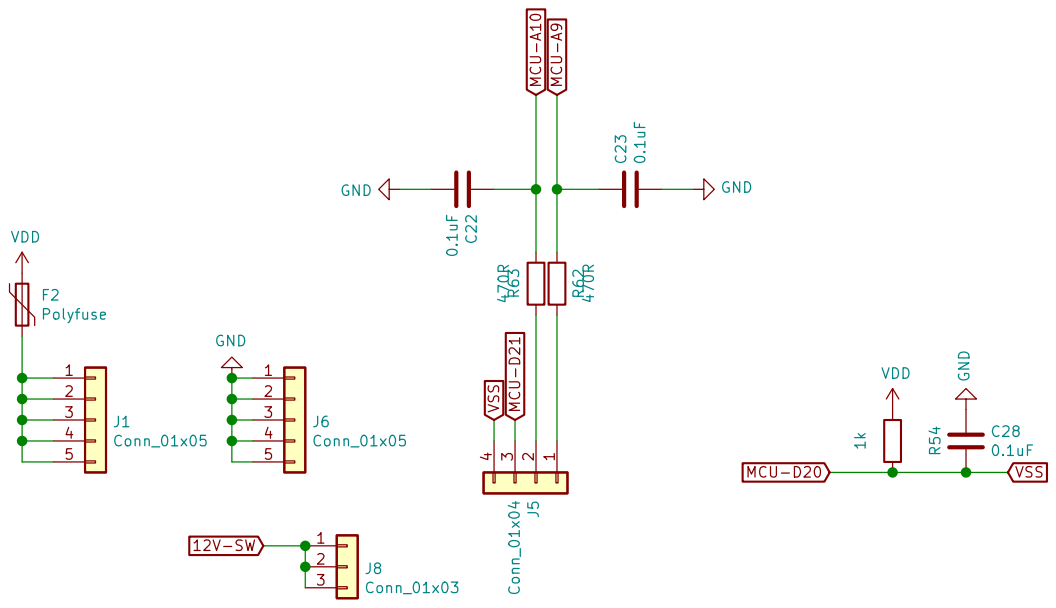
[picture p12: page 7]

1 J5 Conn_01x04 12V-SW MCU-A10 MCU-A9 VSS MCU-D20 VSS MCU-D21

File: proto.sch Sheet: /Proto Area/ Speeduino
