Crann-Data/speeduino-hardware/(list of files, drawings)

Other design files:
v0.4-mini/Interface boards/48 Pin NA Miata/NA Miata 48 pin.fzz
v0.4-mini/THT/Prior versions/v0.4.0/schematic v0.4.fzz
v0.4-mini/THT/Prior versions/v0.4.1/schematic v0.4.1.fzz
v0.4-mini/THT/Prior versions/v0.4.2/schematic v0.4.2.fzz
v0.4-mini/THT/Prior versions/v0.4.3/schematic v0.4.2-smt.fzz
v0.4-mini/THT/Prior versions/v0.4.3/schematic v0.4.3.fzz
v0.4-mini/THT/Prior versions/v0.4.3/schematic v0.4.4-smt.fzz
