Crann-Data/speeduino-hardware/v0.4/THT/Latest/v0.4.3d.kicad_pcb

## KiCad design v0.4/THT/Latest/v0.4.3d.kicad_pcb (2025-05-29)

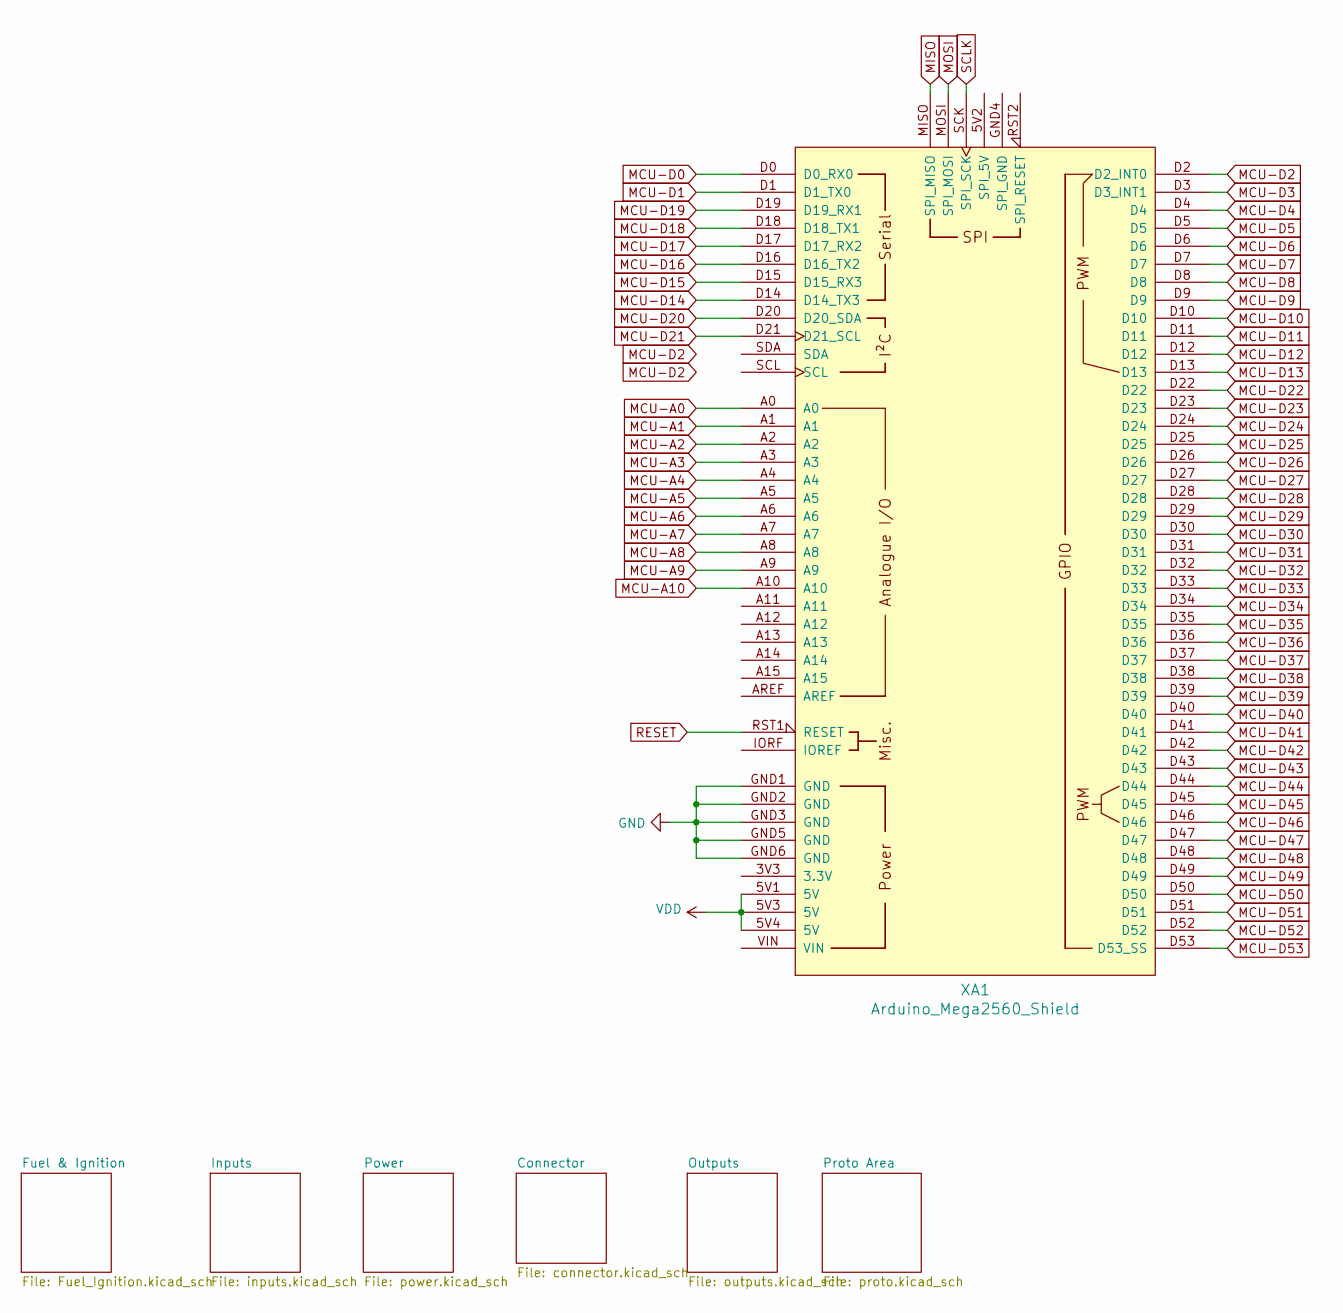
[picture p13: schematic v0.4.3d.kicad_sch, 0.4]

Parts:
XA1: Arduino_Mega2560_Shield; Arduino_Mega2560_Shield_IO_Only

Connections:
ADC-Clamp-2: XA1.A3; also elsewhere on the board
ADC-Clamp-3: XA1.A2; also elsewhere on the board
ADC-Clamp-5: XA1.A0; also elsewhere on the board
ADC-Clamp-6: XA1.A1; also elsewhere on the board
ADC-Clamp-7: XA1.D2 (D2_INT0); also elsewhere on the board
ADC-Clamp-8: XA1.D18 (D18_TX1); also elsewhere on the board
ADC-Clamp-9: XA1.D19 (D19_RX1); also elsewhere on the board
ADC-Clamp-10: XA1.D51; also elsewhere on the board
ADC-Clamp-11: XA1.A8; also elsewhere on the board
ADC-Clamp-12: XA1.A4; also elsewhere on the board
GND: XA1.GND1 (GND), XA1.GND2 (GND), XA1.GND3 (GND), XA1.GND5 (GND), XA1.GND6 (GND); also elsewhere on the board
MCU-A5: XA1.A5; also elsewhere on the board
MCU-A6: XA1.A6
MCU-A7: XA1.A7
MCU-A9: XA1.A9; also elsewhere on the board
MCU-A10: XA1.A10; also elsewhere on the board
MCU-D0: XA1.D0 (D0_RX0); also elsewhere on the board
MCU-D1: XA1.D1 (D1_TX0); also elsewhere on the board
MCU-D3: XA1.D3 (D3_INT1); also elsewhere on the board
MCU-D4: XA1.D4; also elsewhere on the board
MCU-D5: XA1.D5; also elsewhere on the board
MCU-D6: XA1.D6; also elsewhere on the board
MCU-D7: XA1.D7; also elsewhere on the board
MCU-D8: XA1.D8; also elsewhere on the board
MCU-D9: XA1.D9; also elsewhere on the board
MCU-D10: XA1.D10; also elsewhere on the board
MCU-D11: XA1.D11; also elsewhere on the board
MCU-D12: XA1.D12
MCU-D13: XA1.D13
MCU-D14: XA1.D14 (D14_TX3)
MCU-D15: XA1.D15 (D15_RX3)
MCU-D16: XA1.D16 (D16_TX2); also elsewhere on the board
MCU-D17: XA1.D17 (D17_RX2); also elsewhere on the board
MCU-D20: XA1.D20 (D20_SDA); also elsewhere on the board
MCU-D21: XA1.D21 (D21_SCL); also elsewhere on the board
MCU-D22: XA1.D22
MCU-D23: XA1.D23
MCU-D24: XA1.D24; also elsewhere on the board
MCU-D25: XA1.D25
MCU-D26: XA1.D26
MCU-D27: XA1.D27
MCU-D28: XA1.D28
MCU-D29: XA1.D29
MCU-D30: XA1.D30
MCU-D31: XA1.D31
MCU-D32: XA1.D32
MCU-D33: XA1.D33
MCU-D34: XA1.D34
MCU-D35: XA1.D35
MCU-D36: XA1.D36
MCU-D37: XA1.D37
MCU-D38: XA1.D38; also elsewhere on the board
MCU-D39: XA1.D39
MCU-D40: XA1.D40; also elsewhere on the board
MCU-D41: XA1.D41
MCU-D42: XA1.D42
MCU-D43: XA1.D43
MCU-D44: XA1.D44
MCU-D45: XA1.D45; also elsewhere on the board
MCU-D46: XA1.D46
MCU-D47: XA1.D47; also elsewhere on the board
MCU-D48: XA1.D48
MCU-D49: XA1.D49; also elsewhere on the board
MCU-D50: XA1.D50; also elsewhere on the board
MCU-D52: XA1.D52; also elsewhere on the board
MCU-D53: XA1.D53 (D53_SS)
RESET: XA1.RST1 (RESET); also elsewhere on the board
VDD: XA1.5V1 (5V), XA1.5V3 (5V), XA1.5V4 (5V); also elsewhere on the board

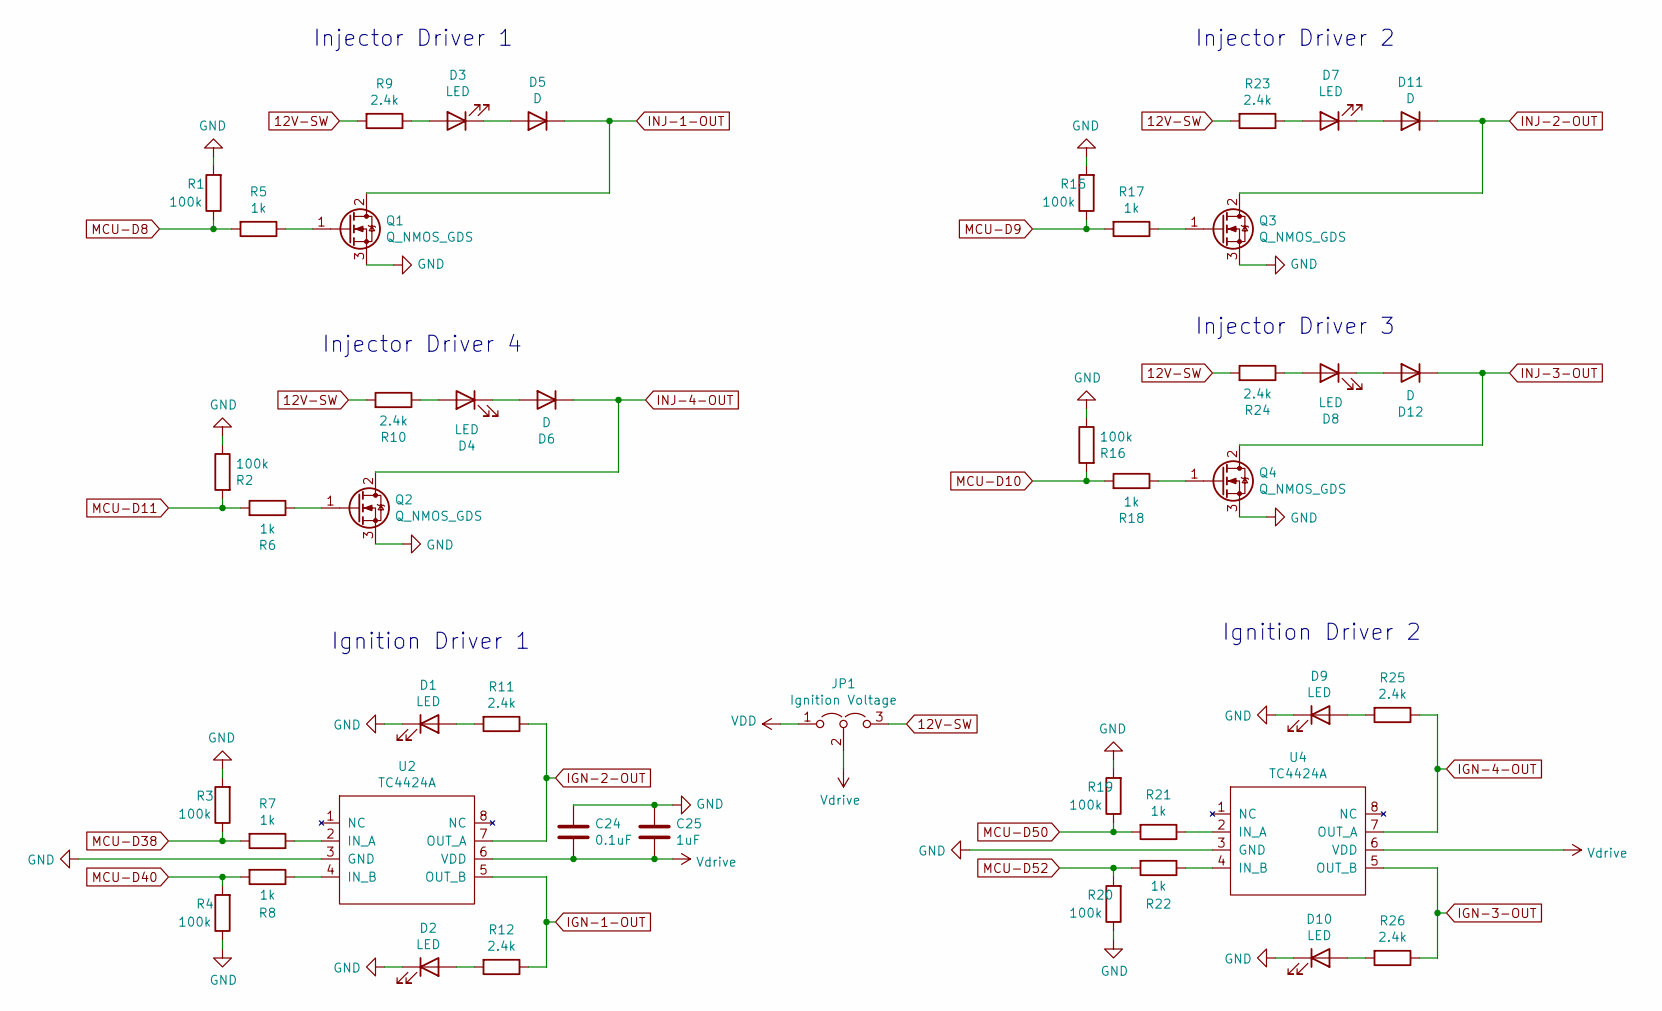
[picture p14: schematic Fuel_Ignition.kicad_sch, 0.4]

Parts:
C24: 0.1uF; C_Disc_D5.0mm_W2.5mm_P2.50mm; Manufacturer_Part_Number FA18X8R1E104KNU06; Digikey Part Number 445-180563-1-ND
C25: 1uF; C_Disc_D5.0mm_W2.5mm_P2.50mm; Manufacturer_Part_Number FA18X7R1E105KRU06; Digikey Part Number 445-180543-1-ND
D1, D2, D3, D4, D7, D8, D9, D10: LED; LED_D3.0mm; Manufacturer_Part_Number 151031SS04000; Digikey Part Number 732-5005-ND
D5, D6, D11, D12: D; D_DO-35_SOD27_P7.62mm_Horizontal; Manufacturer_Part_Number 1N914TAP; Digikey Part Number 1N914TAPGICT-ND
JP1: Ignition Voltage; PinHeader_1x03_P2.54mm_Vertical; Manufacturer_Part_Number M20-9990345; Digikey Part Number 952-2263-ND
Q1, Q2, Q3, Q4: Q_NMOS_GDS; TO-220-3_Horizontal_TabDown; Manufacturer_Part_Number STP62NS04Z; Digikey Part Number 497-5896-5-ND
R1, R2, R3, R4, R15, R16, R19, R20: 100k; R_Axial_DIN0204_L3.6mm_D1.6mm_P5.08mm_Horizontal; Manufacturer_Part_Number MBA02040C1003FCT00; Digikey Part Number BC3240CT-ND
R5, R6, R7, R8, R17, R18, R21, R22: 1k; R_Axial_DIN0204_L3.6mm_D1.6mm_P5.08mm_Horizontal; Manufacturer_Part_Number MBA02040C1001FRP00; Digikey Part Number BC1.00KXCT-ND
R9, R10, R11, R12, R23, R24, R25, R26: 2.4k; R_Axial_DIN0204_L3.6mm_D1.6mm_P5.08mm_Horizontal; Manufacturer_Part_Number MBA02040C2401FC100; Digikey Part Number BC3483CT-ND
U2, U4: TC4424A; DIP-8_W7.62mm_Socket; Manufacturer_Part_Number TC4424AVPA; Digikey Part Number TC4424AVPA-ND

Connections:
12V-SW: JP1.3 (B), R9.2, R10.2, R23.2, R24.2; also elsewhere on the board
GND: C24.1, C25.1, D1.1 (K), D2.1 (K), D9.1 (K), D10.1 (K), Q1.3 (S), Q2.3 (S), Q3.3 (S), Q4.3 (S), R1.2, R2.1, R3.2, R4.1, R15.2, R16.1, R19.2, R20.1, U2.3 (GND), U4.3 (GND); also elsewhere on the board
IGN-1-OUT: R12.1, U2.5 (OUT_B); also elsewhere on the board
IGN-2-OUT: R11.1, U2.7 (OUT_A); also elsewhere on the board
IGN-3-OUT: R26.1, U4.5 (OUT_B); also elsewhere on the board
IGN-4-OUT: R25.1, U4.7 (OUT_A); also elsewhere on the board
INJ-1-OUT: D5.1 (K), Q1.2 (D); also elsewhere on the board
INJ-2-OUT: D11.1 (K), Q3.2 (D); also elsewhere on the board
INJ-3-OUT: D12.1 (K), Q4.2 (D); also elsewhere on the board
INJ-4-OUT: D6.1 (K), Q2.2 (D); also elsewhere on the board
MCU-D8: R1.1, R5.2; also elsewhere on the board
MCU-D9: R15.1, R17.2; also elsewhere on the board
MCU-D10: R16.2, R18.2; also elsewhere on the board
MCU-D11: R2.2, R6.2; also elsewhere on the board
MCU-D38: R3.1, R7.2; also elsewhere on the board
MCU-D40: R4.2, R8.2; also elsewhere on the board
MCU-D50: R19.1, R21.2; also elsewhere on the board
MCU-D52: R20.2, R22.2; also elsewhere on the board
unnamed: D1.2 (A), R11.2
unnamed: D2.2 (A), R12.2
unnamed: D3.1 (K), D5.2 (A)
unnamed: D3.2 (A), R9.1
unnamed: D4.1 (K), D6.2 (A)
unnamed: D4.2 (A), R10.1
unnamed: D7.2 (A), R23.1
unnamed: D8.2 (A), R24.1
unnamed: D9.2 (A), R25.2
unnamed: D10.2 (A), R26.2
unnamed: D7.1 (K), D11.2 (A)
unnamed: D8.1 (K), D12.2 (A)
unnamed: Q1.1 (G), R5.1
unnamed: Q2.1 (G), R6.1
unnamed: Q3.1 (G), R17.1
unnamed: Q4.1 (G), R18.1
unnamed: R7.1, U2.2 (IN_A)
unnamed: R8.1, U2.4 (IN_B)
unnamed: R21.1, U4.2 (IN_A)
unnamed: R22.1, U4.4 (IN_B)
VDD: JP1.1 (A); also elsewhere on the board
Vdrive: C24.2, C25.2, JP1.2 (C), U2.6 (VDD), U4.6 (VDD)

Notes on the sheet:
Injector Driver 3
Ignition Driver 2
Injector Driver 1
Injector Driver 2
Injector Driver 4
Ignition Driver 1

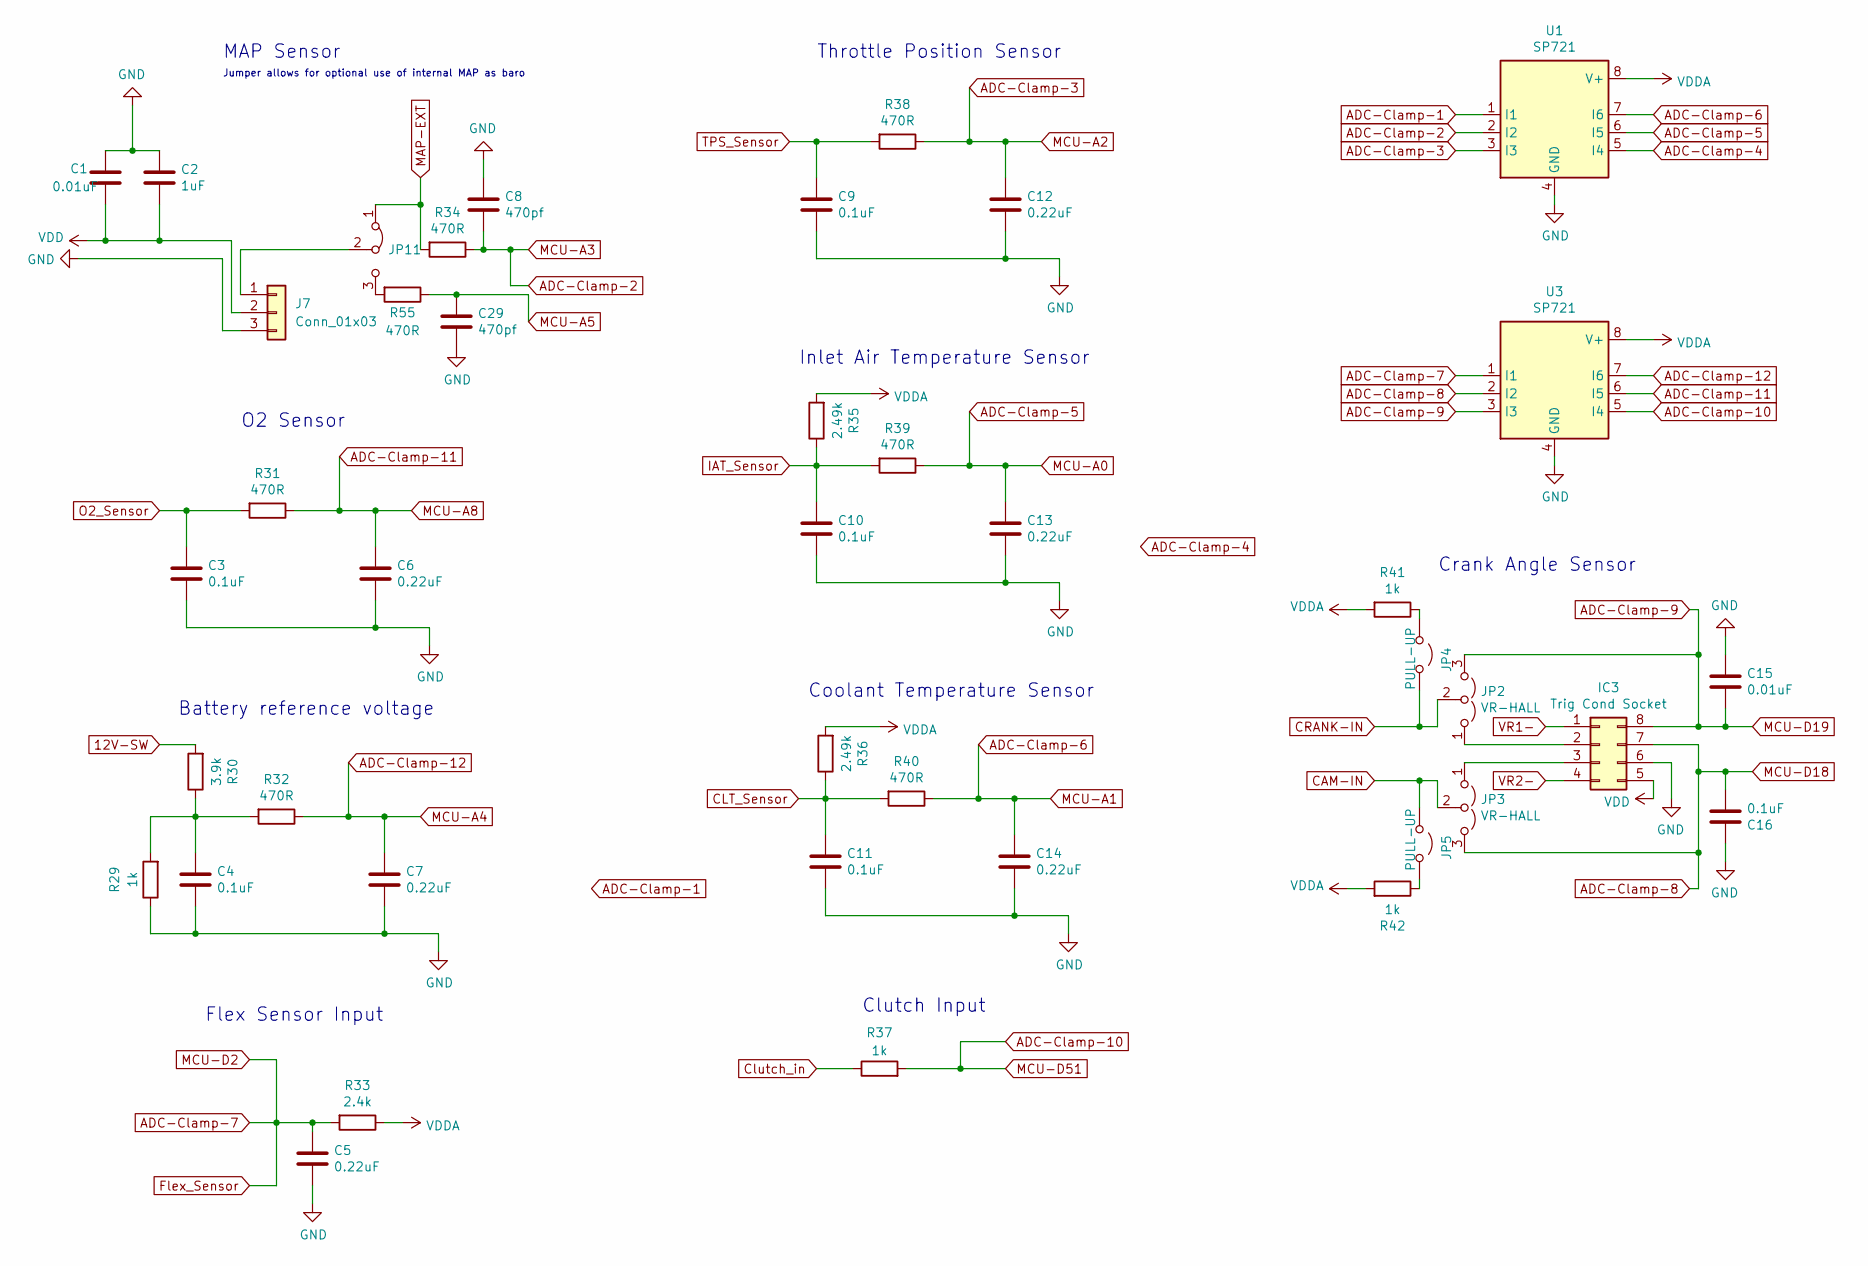
[picture p15: schematic inputs.kicad_sch, 0.4]

Parts:
C1, C15: 0.01uF; C_Disc_D5.0mm_W2.5mm_P2.50mm; Manufacturer_Part_Number FA18X7R1H103KNU06; Digikey Part Number 445-174244-1-ND
C2: 1uF; C_Disc_D5.0mm_W2.5mm_P2.50mm; Manufacturer_Part_Number FA18X7R1E105KRU06; Digikey Part Number 445-180543-1-ND
C3, C4, C9, C10, C11, C16: 0.1uF; C_Disc_D5.0mm_W2.5mm_P2.50mm; Manufacturer_Part_Number FA18X8R1E104KNU06; Digikey Part Number 445-180563-1-ND
C5, C6, C7, C12, C13, C14: 0.22uF; C_Disc_D5.0mm_W2.5mm_P2.50mm; Manufacturer_Part_Number FA18X8R1E224KRU06; Digikey Part Number 445-180564-1-ND
C8, C29: 470pf; C_Disc_D5.0mm_W2.5mm_P2.50mm; Manufacturer_Part_Number FA18NP01H471JNU06; Digikey Part Number 445-180522-1-ND
IC3: Trig Cond Socket; DIP-8_W7.62mm_Socket
J7: Conn_01x03
JP2, JP3: VR-HALL; PinHeader_1x03_P2.54mm_Vertical; Manufacturer_Part_Number M20-9990345; Digikey Part Number 952-2263-ND
JP4, JP5: PULL-UP; PinHeader_1x02_P2.54mm_Vertical; Manufacturer_Part_Number M20-9990245; Digikey Part Number 952-2261-ND
JP11: Jumper_3_Bridged12; SolderJumper-3_P1.3mm_Bridged12_RoundedPad1.0x1.5mm
R29, R37, R41, R42: 1k; R_Axial_DIN0204_L3.6mm_D1.6mm_P5.08mm_Horizontal; Manufacturer_Part_Number MBA02040C1001FRP00; Digikey Part Number BC1.00KXCT-ND
R30: 3.9k; R_Axial_DIN0204_L3.6mm_D1.6mm_P5.08mm_Horizontal; Manufacturer_Part_Number MBA02040C3901FCT00; Digikey Part Number BC3272CT-ND
R31, R32, R34, R38, R39, R40, R55: 470R; R_Axial_DIN0204_L3.6mm_D1.6mm_P5.08mm_Horizontal; Manufacturer_Part_Number MBA02040C4700FRP00; Digikey Part Number BC3516CT-ND
R33: 2.4k; R_Axial_DIN0204_L3.6mm_D1.6mm_P5.08mm_Horizontal; Manufacturer_Part_Number MBA02040C2401FC100; Digikey Part Number BC3483CT-ND
R35, R36: 2.49k; R_Axial_DIN0204_L3.6mm_D1.6mm_P5.08mm_Horizontal; Manufacturer_Part_Number MBA02040C2491FRP00; Digikey Part Number BC2.49KXCT-ND
U1, U3: SP721; DIP-8_W7.62mm; Manufacturer_Part_Number SP721APP; Digikey Part Number F2720-ND

Connections:
12V-SW: R30.2; also elsewhere on the board
ADC-Clamp-1: U1.1 (I1)
ADC-Clamp-2: C8.2, R34.1, U1.2 (I2); also elsewhere on the board
ADC-Clamp-3: C12.1, R38.1, U1.3 (I3); also elsewhere on the board
ADC-Clamp-4: U1.5 (I4)
ADC-Clamp-5: C13.1, R39.1, U1.6 (I5); also elsewhere on the board
ADC-Clamp-6: C14.1, R40.1, U1.7 (I6); also elsewhere on the board
ADC-Clamp-7: C5.1, R33.2, U3.1 (I1); also elsewhere on the board
ADC-Clamp-8: C16.2, IC3.7, JP3.3 (B), U3.2 (I2); also elsewhere on the board
ADC-Clamp-9: C15.2, IC3.8, JP2.3 (B), U3.3 (I3); also elsewhere on the board
ADC-Clamp-10: R37.2, U3.5 (I4); also elsewhere on the board
ADC-Clamp-11: C6.1, R31.1, U3.6 (I5); also elsewhere on the board
ADC-Clamp-12: C7.1, R32.1, U3.7 (I6); also elsewhere on the board
CAM-IN: JP3.2 (C), JP5.1 (A); also elsewhere on the board
CLT_Sensor: C11.1, R36.1, R40.2; also elsewhere on the board
CRANK-IN: JP2.2 (C), JP4.1 (A); also elsewhere on the board
Clutch_in: R37.1; also elsewhere on the board
GND: C1.1, C2.1, C3.2, C4.2, C5.2, C6.2, C7.2, C8.1, C9.2, C10.2, C11.2, C12.2, C13.2, C14.2, C15.1, C16.1, C29.2, IC3.6, J7.3, R29.1, U1.4 (GND), U3.4 (GND); also elsewhere on the board
IAT_Sensor: C10.1, R35.1, R39.2; also elsewhere on the board
MAP-EXT: JP11.1 (A), R34.2; also elsewhere on the board
MCU-A5: C29.1, R55.1; also elsewhere on the board
unnamed: C4.1, R29.2, R30.1, R32.2
unnamed: IC3.2, JP2.1 (A)
unnamed: IC3.3, JP3.1 (A)
unnamed: JP4.2 (B), R41.1
unnamed: JP5.2 (B), R42.1
unnamed: J7.1, JP11.2 (C)
unnamed: JP11.3 (B), R55.2
O2_Sensor: C3.1, R31.2; also elsewhere on the board
TPS_Sensor: C9.1, R38.2; also elsewhere on the board
VDD: C1.2, C2.2, IC3.5, J7.2; also elsewhere on the board
VDDA: R33.1, R35.2, R36.2, R41.2, R42.2, U1.8 (V+), U3.8 (V+); also elsewhere on the board
VR1-: IC3.1; also elsewhere on the board
VR2-: IC3.4; also elsewhere on the board

Notes on the sheet:
Coolant Temperature Sensor
Jumper allows for optional use of internal MAP as baro
MAP Sensor
Crank Angle Sensor
Battery reference voltage
Throttle Position Sensor
Inlet Air Temperature Sensor
O2 Sensor
Flex Sensor Input
Clutch Input

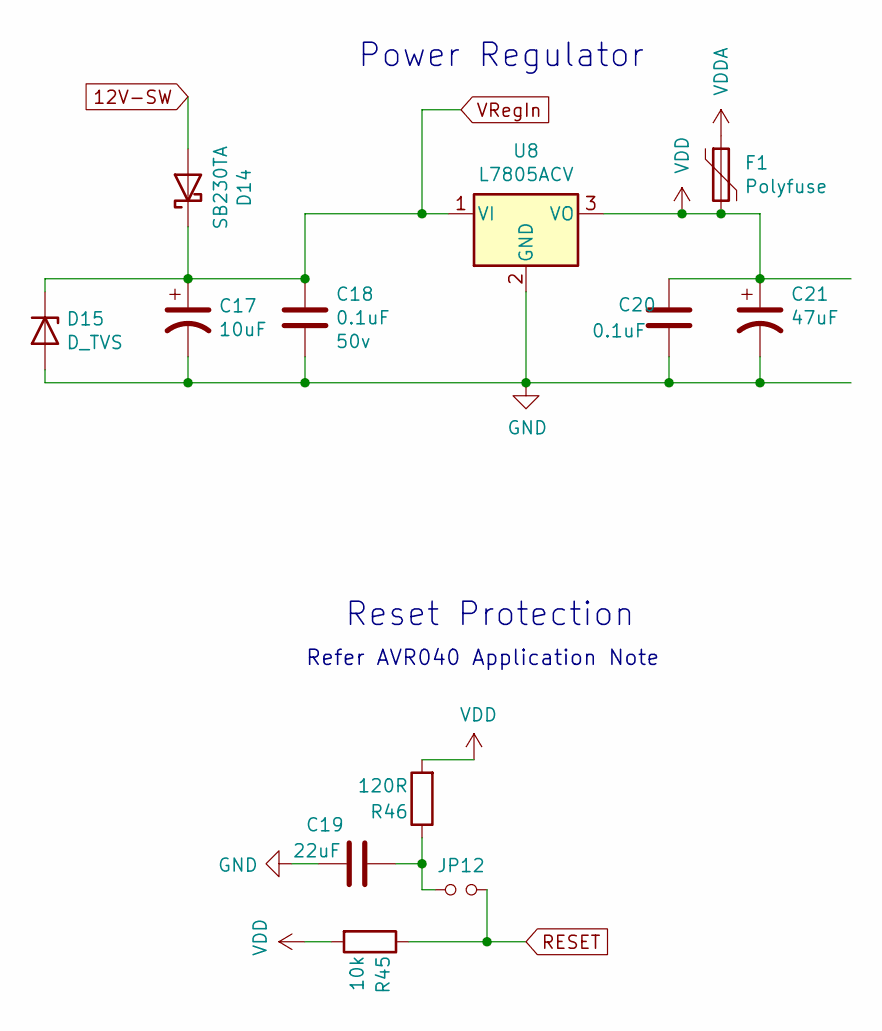
[picture p16: schematic power.kicad_sch, 0.4]

Parts:
C17: 10uF; CP_Radial_D5.0mm_P2.00mm; Voltage 50v; Manufacturer_Part_Number EEU-FC1H100L; Digikey Part Number P10316-ND
C18: 0.1uF; C_Disc_D5.0mm_W2.5mm_P2.50mm; Voltage 50v; Manufacturer_Part_Number FA18X8R1E104KNU06; Digikey Part Number 445-180563-1-ND
C19: 22uF; C_Disc_D7.5mm_W5.0mm_P5.00mm; Manufacturer_Part_Number FA22X7R1E226MRU06; Digikey Part Number 445-180603-1-ND
C20: 0.1uF; C_Disc_D5.0mm_W2.5mm_P2.50mm; Manufacturer_Part_Number FA18X8R1E104KNU06; Digikey Part Number 445-180563-1-ND
C21: 47uF; CP_Radial_D8.0mm_P5.00mm; Manufacturer_Part_Number EEU-FC1H470B; Digikey Part Number P19658CT-ND
D14: SB230TA; D_DO-41_SOD81_P7.62mm_Horizontal; Manufacturer_Part_Number SB230TA; Digikey Part Number 1655-1518-1-ND
D15: D_TVS; D_DO-15_P12.70mm_Horizontal; Manufacturer_Part_Number TP6KE47A; Digikey Part Number F6853CT-ND
F1: Polyfuse; Fuse_BelFuse_0ZRE0055FF_L14.0mm_W4.1mm; Manufacturer_Part_Number 0ZRP0050FF1E; Digikey Part Number 507-2403-ND
JP12: Jumper_NO_Small; PinHeader_1x02_P2.54mm_Vertical
R45: 10k; R_Axial_DIN0204_L3.6mm_D1.6mm_P5.08mm_Horizontal; Manufacturer_Part_Number MBA02040C1002FRP00; Digikey Part Number BC10.0KXCT-ND
R46: 120R; R_Axial_DIN0204_L3.6mm_D1.6mm_P5.08mm_Horizontal; Manufacturer_Part_Number MBA02040C1200FC100; Digikey Part Number BC3453CT-ND
U8: L7805ACV; TO-220-3_Horizontal_TabDown; Manufacturer_Part_Number L7805ACV; Digikey Part Number 497-1441-5-ND

Connections:
12V-SW: D14.2 (A); also elsewhere on the board
GND: C17.2, C18.2, C19.2, C20.2, C21.2, D15.2 (A), U8.2 (GND); also elsewhere on the board
unnamed: C19.1, JP12.1, R46.1
RESET: JP12.2, R45.1; also elsewhere on the board
VDD: C20.1, C21.1, F1.2, R45.2, R46.2, U8.3 (VO); also elsewhere on the board
VDDA: F1.1; also elsewhere on the board
VRegIn: C17.1, C18.1, D14.1 (K), D15.1 (K), U8.1 (VI)

Notes on the sheet:
Power Regulator
Reset Protection
Refer AVR040 Application Note

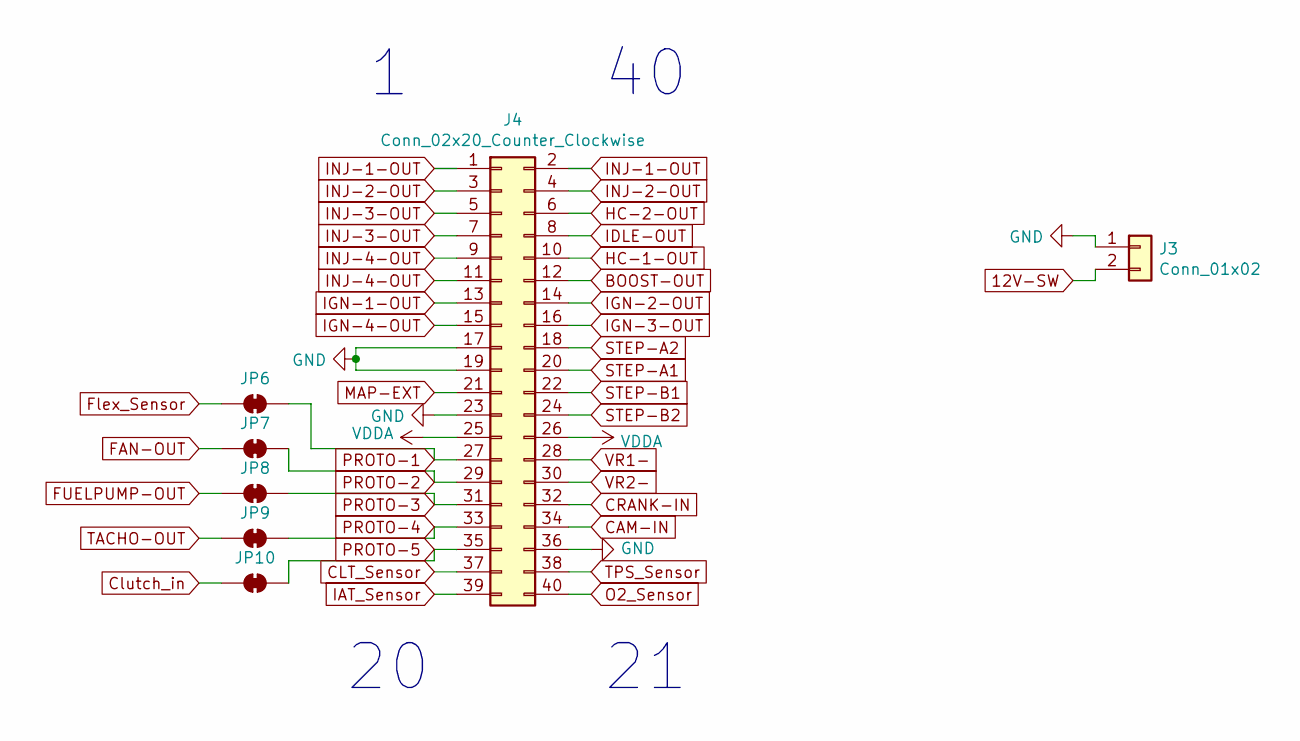
[picture p17: schematic connector.kicad_sch, 0.4]

Parts:
J3: Conn_01x02; TerminalBlock_Phoenix_PT-1,5-2-5.0-H_1x02_P5.00mm_Horizontal
J4: Conn_02x20_Counter_Clockwise; IDC-Header_2x20_P2.54mm_Vertical
JP6, JP7, JP8, JP9, JP10: SolderJumper_2_Bridged; SolderJumper-2_P1.3mm_Bridged_Pad1.0x1.5mm

Connections:
12V-SW: J3.2; also elsewhere on the board
ADC-Clamp-7: JP6.1 (A); also elsewhere on the board
BOOST-OUT: J4.12; also elsewhere on the board
CAM-IN: J4.34; also elsewhere on the board
CLT_Sensor: J4.37; also elsewhere on the board
CRANK-IN: J4.32; also elsewhere on the board
Clutch_in: JP10.1 (A); also elsewhere on the board
FAN-OUT: JP7.1 (A); also elsewhere on the board
FUELPUMP-OUT: JP8.1 (A); also elsewhere on the board
GND: J3.1, J4.17, J4.19, J4.23, J4.36; also elsewhere on the board
HC-1-OUT: J4.10; also elsewhere on the board
HC-2-OUT: J4.6; also elsewhere on the board
IAT_Sensor: J4.39; also elsewhere on the board
IDLE-OUT: J4.8; also elsewhere on the board
IGN-1-OUT: J4.13; also elsewhere on the board
IGN-2-OUT: J4.14; also elsewhere on the board
IGN-3-OUT: J4.16; also elsewhere on the board
IGN-4-OUT: J4.15; also elsewhere on the board
INJ-1-OUT: J4.1, J4.2; also elsewhere on the board
INJ-2-OUT: J4.3, J4.4; also elsewhere on the board
INJ-3-OUT: J4.5, J4.7; also elsewhere on the board
INJ-4-OUT: J4.9, J4.11; also elsewhere on the board
MAP-EXT: J4.21; also elsewhere on the board
O2_Sensor: J4.40; also elsewhere on the board
PROTO-1: J4.27, JP6.2 (B)
PROTO-2: J4.29, JP7.2 (B)
PROTO-3: J4.31, JP8.2 (B)
PROTO-4: J4.33, JP9.2 (B)
PROTO-5: J4.35, JP10.2 (B)
STEP-A1: J4.20; also elsewhere on the board
STEP-A2: J4.18; also elsewhere on the board
STEP-B1: J4.22; also elsewhere on the board
STEP-B2: J4.24; also elsewhere on the board
TACHO-OUT: JP9.1 (A); also elsewhere on the board
TPS_Sensor: J4.38; also elsewhere on the board
VDDA: J4.25, J4.26; also elsewhere on the board
VR1-: J4.28; also elsewhere on the board
VR2-: J4.30; also elsewhere on the board

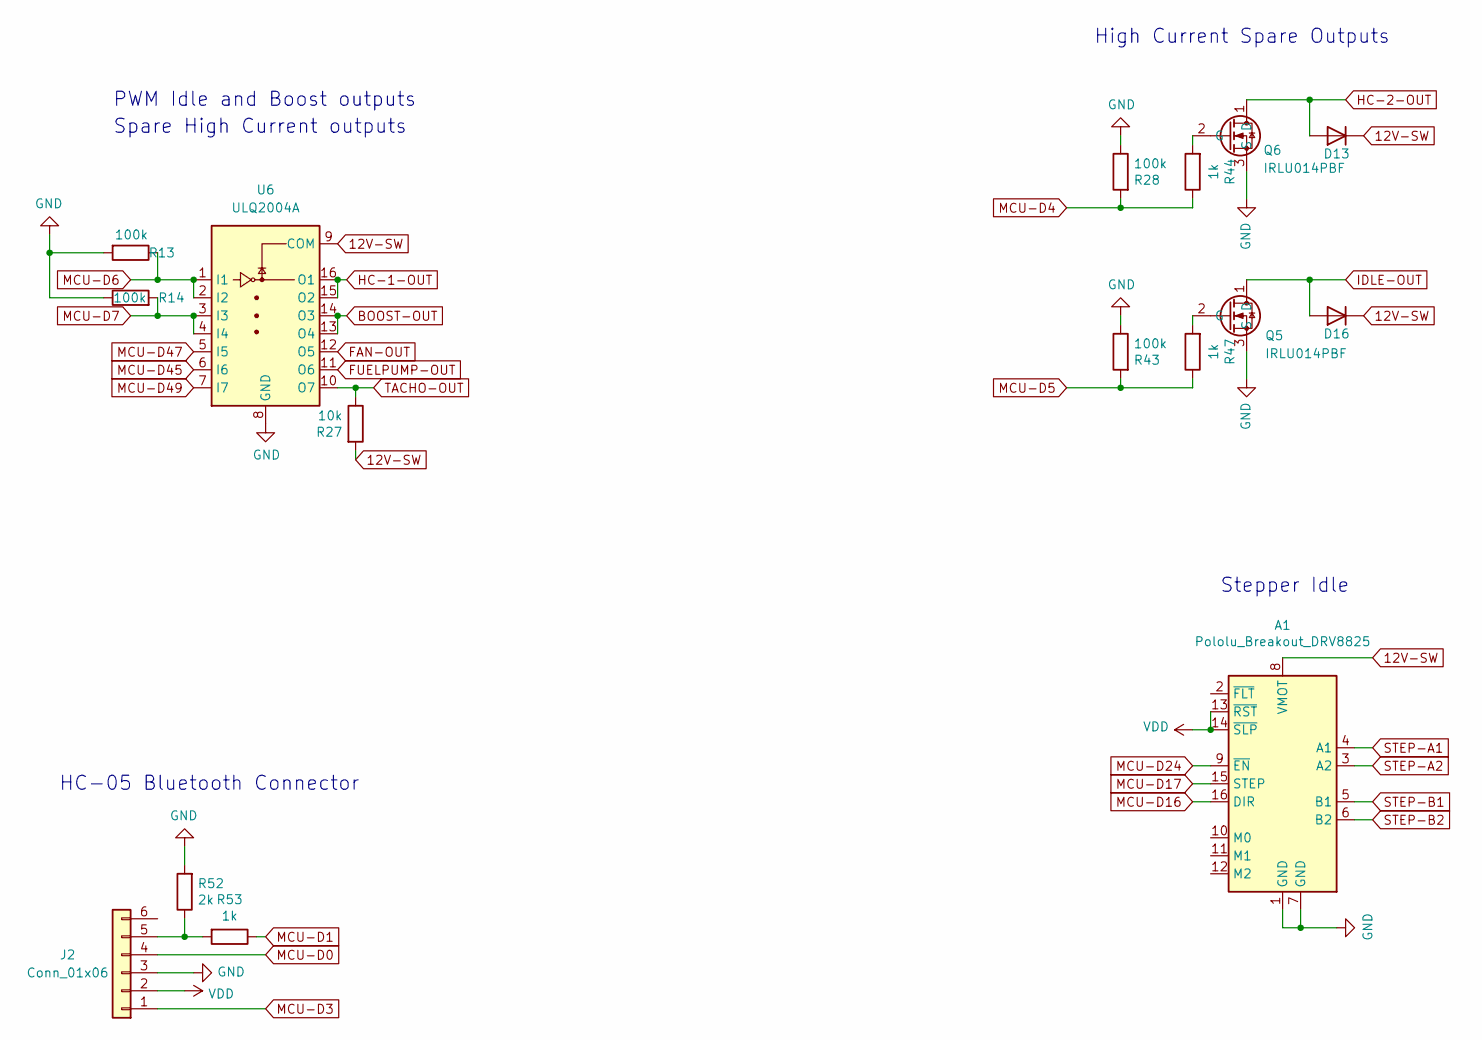
[picture p18: schematic outputs.kicad_sch, 0.4]

Parts:
A1: Pololu_Breakout_DRV8825; Pololu_Breakout-16_15.2x20.3mm
D13, D16: D; D_DO-35_SOD27_P7.62mm_Horizontal; Manufacturer_Part_Number 1N914TAP; Digikey Part Number 1N914TAPGICT-ND
J2: Conn_01x06; PinHeader_1x06_P2.54mm_Vertical
Q5, Q6: IRLU014PBF; 251-3_Vertical
R13, R14, R28, R43: 100k; R_Axial_DIN0204_L3.6mm_D1.6mm_P5.08mm_Horizontal; Manufacturer_Part_Number MBA02040C1003FCT00; Digikey Part Number BC3240CT-ND
R27: 10k; R_Axial_DIN0204_L3.6mm_D1.6mm_P5.08mm_Horizontal; Manufacturer_Part_Number MBA02040C1002FRP00; Digikey Part Number BC10.0KXCT-ND
R44, R47, R53: 1k; R_Axial_DIN0204_L3.6mm_D1.6mm_P5.08mm_Horizontal; Manufacturer_Part_Number MBA02040C1001FRP00; Digikey Part Number BC1.00KXCT-ND
R52: 2k; R_Axial_DIN0204_L3.6mm_D1.6mm_P5.08mm_Horizontal; Manufacturer_Part_Number MBA02040C2001FCT00; Digikey Part Number BC3254CT-ND
U6: ULQ2004A

Connections:
12V-SW: A1.8 (VMOT), D13.1 (K), D16.1 (K), R27.2, U6.9 (COM); also elsewhere on the board
BOOST-OUT: U6.13 (O4), U6.14 (O3); also elsewhere on the board
FAN-OUT: U6.12 (O5); also elsewhere on the board
FUELPUMP-OUT: U6.11 (O6); also elsewhere on the board
GND: A1.1 (GND), A1.7 (GND), J2.3, Q5.3 (S), Q6.3 (S), R13.2, R14.1, R28.1, R43.1, R52.2, U6.8 (GND); also elsewhere on the board
HC-1-OUT: U6.15 (O2), U6.16 (O1); also elsewhere on the board
HC-2-OUT: D13.2 (A), Q6.1 (D); also elsewhere on the board
IDLE-OUT: D16.2 (A), Q5.1 (D); also elsewhere on the board
MCU-D0: J2.4; also elsewhere on the board
MCU-D1: R53.1; also elsewhere on the board
MCU-D3: J2.1; also elsewhere on the board
MCU-D4: R28.2, R44.1; also elsewhere on the board
MCU-D5: R43.2, R47.1; also elsewhere on the board
MCU-D6: R13.1, U6.1 (I1), U6.2 (I2); also elsewhere on the board
MCU-D7: R14.2, U6.3 (I3), U6.4 (I4); also elsewhere on the board
MCU-D16: A1.16 (DIR); also elsewhere on the board
MCU-D17: A1.15 (STEP); also elsewhere on the board
MCU-D24: A1.9 (~EN); also elsewhere on the board
MCU-D45: U6.6 (I6); also elsewhere on the board
MCU-D47: U6.5 (I5); also elsewhere on the board
MCU-D49: U6.7 (I7); also elsewhere on the board
unnamed: J2.5, R52.1, R53.2
unnamed: Q5.2 (G), R47.2
unnamed: Q6.2 (G), R44.2
STEP-A1: A1.4 (A1); also elsewhere on the board
STEP-A2: A1.3 (A2); also elsewhere on the board
STEP-B1: A1.5 (B1); also elsewhere on the board
STEP-B2: A1.6 (B2); also elsewhere on the board
TACHO-OUT: R27.1, U6.10 (O7); also elsewhere on the board
VDD: A1.13 (~RST), A1.14 (~SLP), J2.2; also elsewhere on the board

Notes on the sheet:
HC-05 Bluetooth Connector
Stepper Idle
High Current Spare Outputs
Spare High Current outputs
PWM Idle and Boost outputs

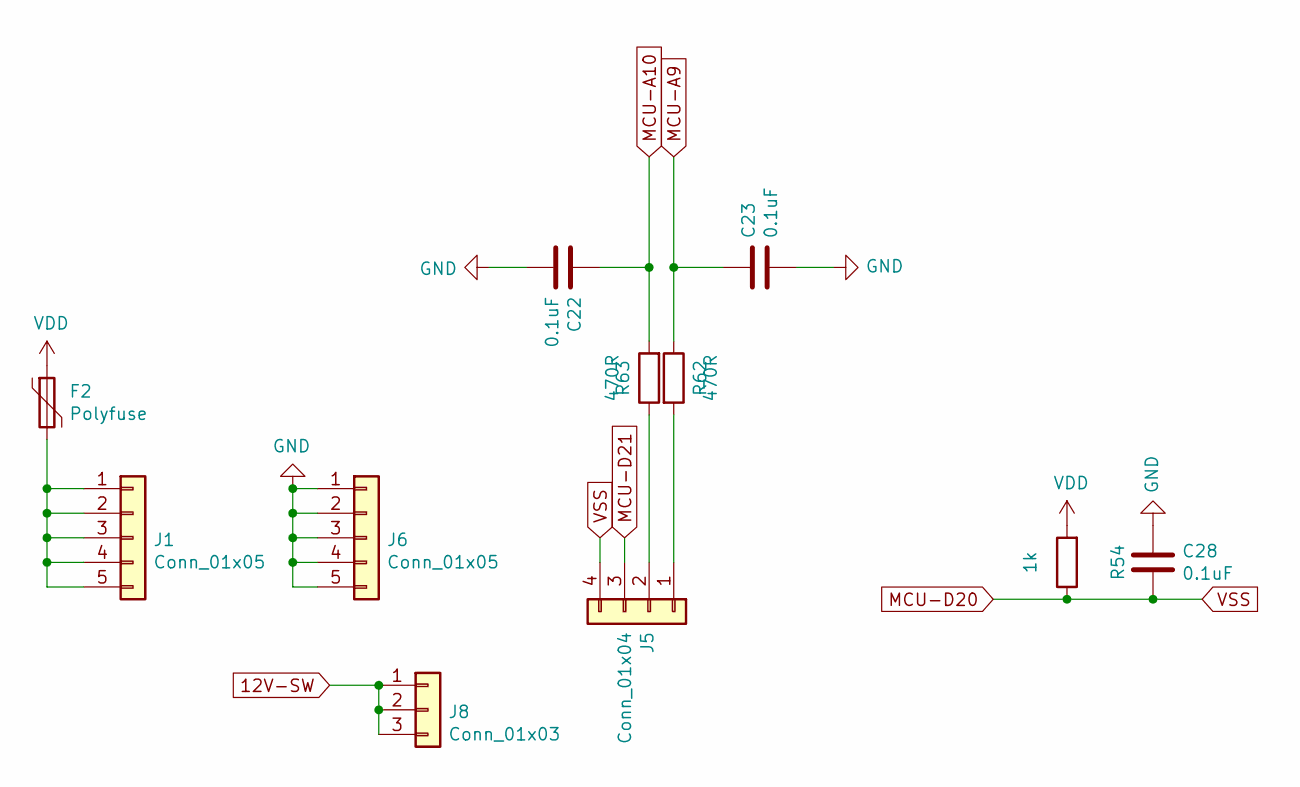
[picture p19: schematic proto.kicad_sch, 0.4]

Parts:
C22, C23, C28: 0.1uF; C_Disc_D5.0mm_W2.5mm_P2.50mm; Manufacturer_Part_Number FA18X8R1E104KNU06; Digikey Part Number 445-180563-1-ND
F2: Polyfuse; Fuse_BelFuse_0ZRE0055FF_L14.0mm_W4.1mm; Manufacturer_Part_Number 0ZRP0050FF1E; Digikey Part Number 507-2403-ND
J1, J6: Conn_01x05; PinHeader_1x05_P2.54mm_Vertical
J5: Conn_01x04; PinHeader_1x04_P2.54mm_Vertical
J8: Conn_01x03; PinHeader_1x03_P2.54mm_Vertical
R54: 1k; R_Axial_DIN0204_L3.6mm_D1.6mm_P5.08mm_Horizontal; Manufacturer_Part_Number MBA02040C1001FRP00; Digikey Part Number BC1.00KXCT-ND
R62, R63: 470R; R_Axial_DIN0204_L3.6mm_D1.6mm_P5.08mm_Horizontal; Manufacturer_Part_Number MBA02040C4700FRP00; Digikey Part Number BC3516CT-ND

Connections:
12V-SW: J8.1, J8.2, J8.3; also elsewhere on the board
GND: C22.2, C23.2, C28.1, J6.1, J6.2, J6.3, J6.4, J6.5; also elsewhere on the board
MCU-A9: C23.1, R63.1; also elsewhere on the board
MCU-A10: C22.1, R62.2; also elsewhere on the board
MCU-D20: C28.2, J5.4, R54.1; also elsewhere on the board
MCU-D21: J5.3; also elsewhere on the board
unnamed: F2.2, J1.1, J1.2, J1.3, J1.4, J1.5
unnamed: J5.1, R63.2
unnamed: J5.2, R62.1
VDD: F2.1, R54.2; also elsewhere on the board
