Crann-Data/speeduino-hardware/v0.4/THT/Latest/v0.4.3d.kicad_pcb

## KiCad design v0.4/THT/Latest/v0.4.3d.kicad_pcb (continued)

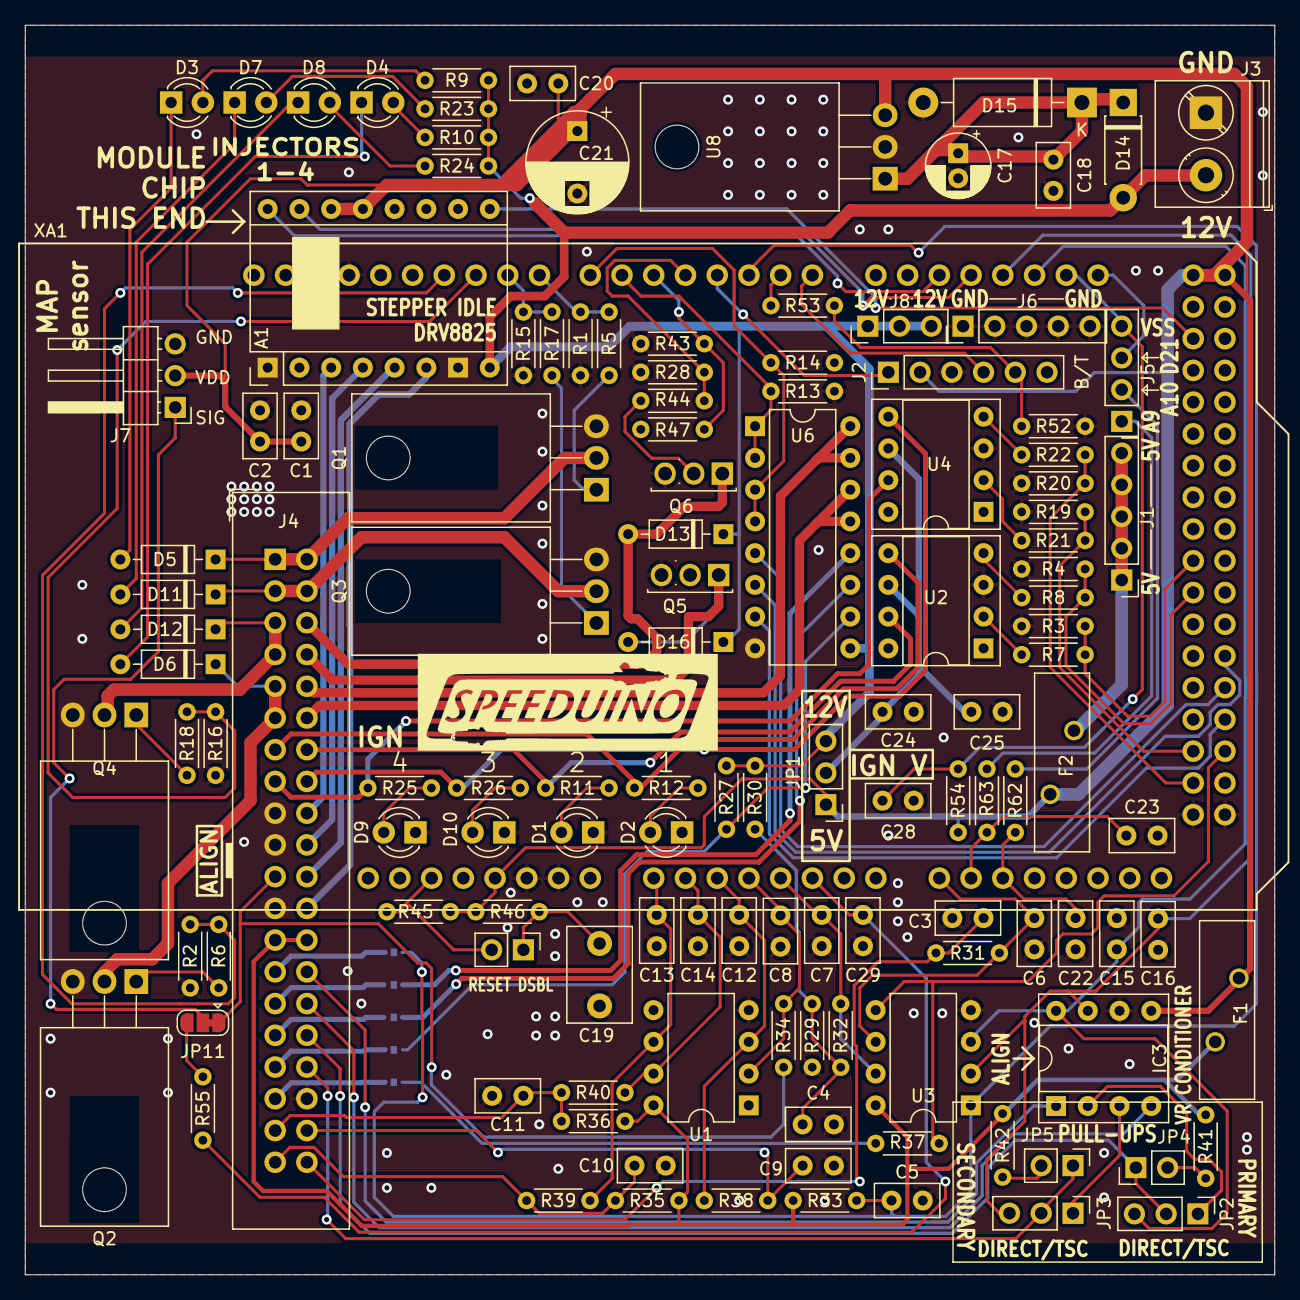
[picture p20: board v0.4.3d.kicad_pcb from above]

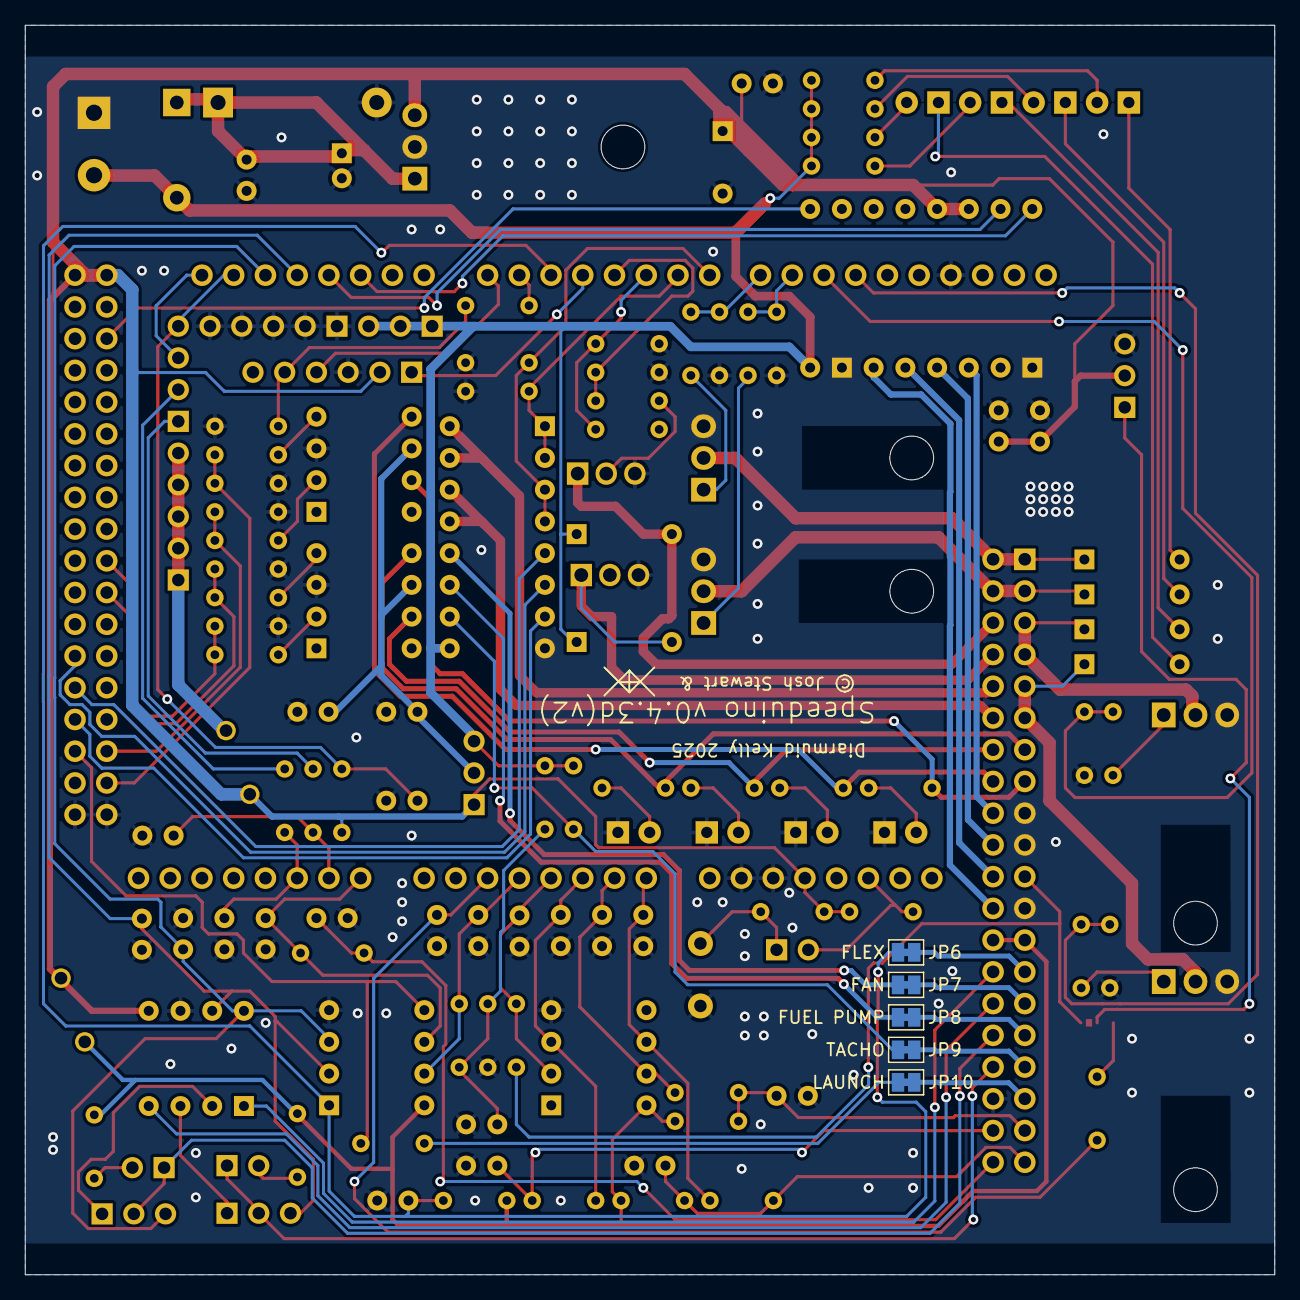
[picture p21: board v0.4.3d.kicad_pcb from below]

Board: 2 copper layers, 100.0 x 100.0 mm, 133 parts (5 on the bottom side), 111 nets.
