Crann-Data/speeduino-hardware/v0.4-mini/Interface boards/Screw terminals/Screw terminal interface.kicad_pcb

## KiCad design v0.4-mini/Interface boards/Screw terminals/Screw terminal interface.kicad_pcb (2025-05-28)

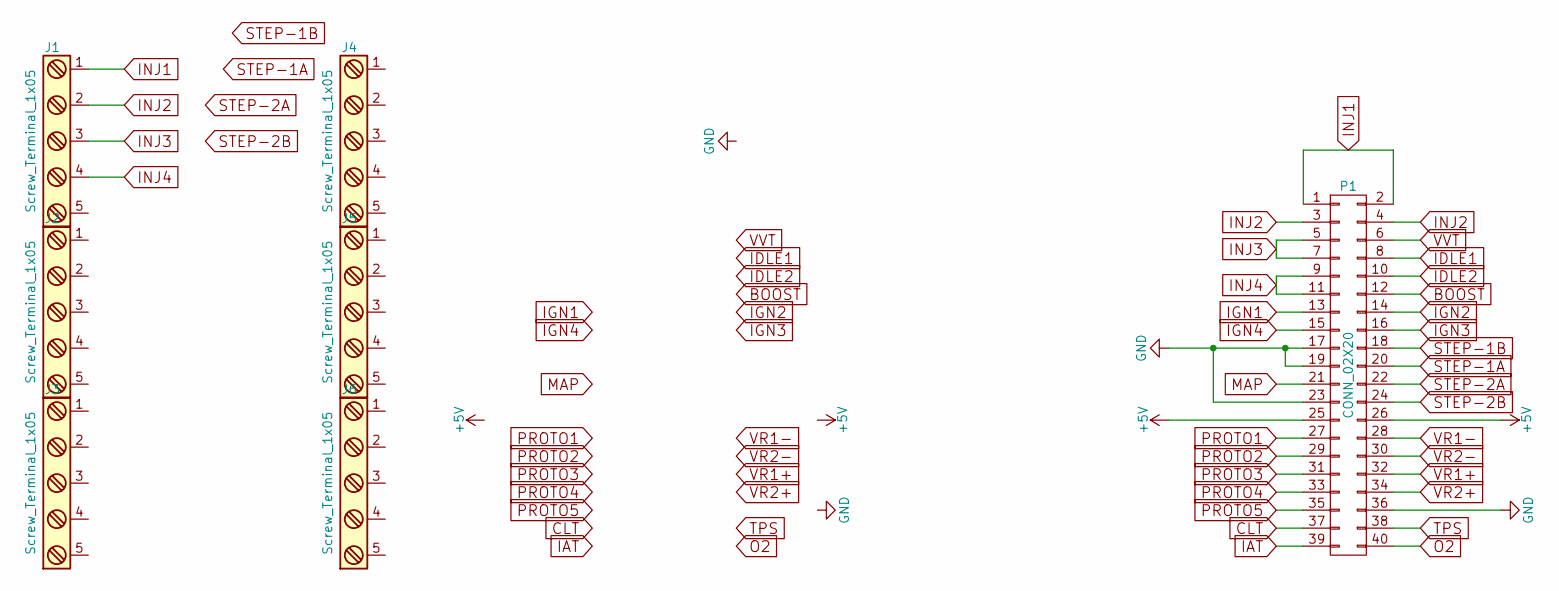
[picture p22: schematic Screw terminal interface.sch]

Parts:
J1, J2, J3, J4, J5, J6: Screw_Terminal_1x05; TerminalBlock_Phoenix_PT-1,5-5-5.0-H_1x05_P5.00mm_Horizontal
P1: CONN_02X20; IDC_Header_Straight_40pins

Connections:
+5V: P1.25, P1.26
BOOST: P1.12
CLT: P1.37
GND: P1.17, P1.19, P1.23, P1.36
IAT: P1.39
IDLE1: P1.8
IDLE2: P1.10
IGN1: P1.13
IGN2: P1.14
IGN3: P1.16
IGN4: P1.15
INJ1: J1.1, P1.1, P1.2
INJ2: J1.2, P1.3, P1.4
INJ3: J1.3, P1.5, P1.7
INJ4: J1.4, P1.9, P1.11
MAP: P1.21
O2: P1.40
PROTO1: P1.27
PROTO2: P1.29
PROTO3: P1.31
PROTO4: P1.33
PROTO5: P1.35
STEP-1A: P1.20
STEP-1B: P1.18
STEP-2A: P1.22
STEP-2B: P1.24
TPS: P1.38
VR1+: P1.32
VR1-: P1.28
VR2+: P1.34
VR2-: P1.30
VVT: P1.6

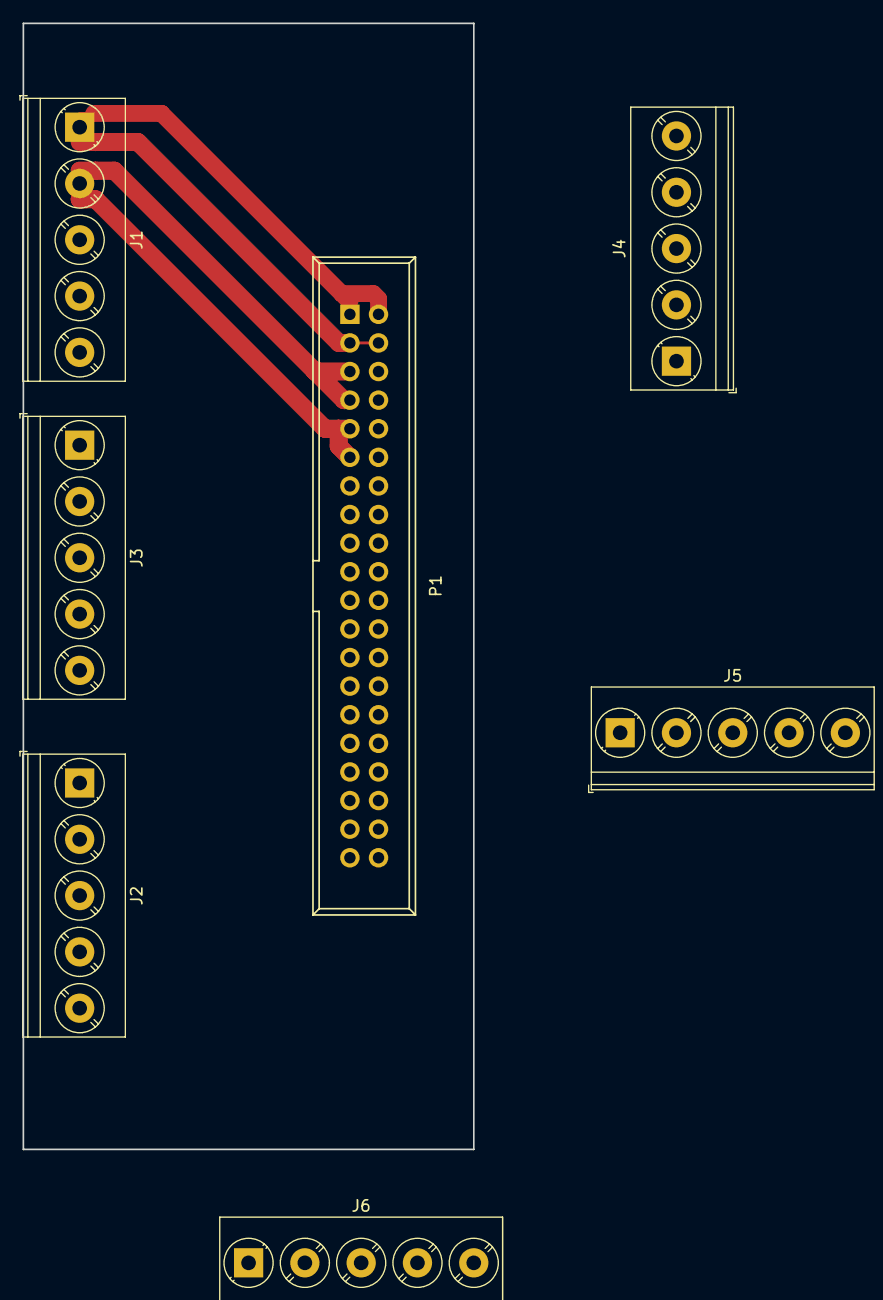
[picture p23: board Screw terminal interface.kicad_pcb from above]

Board: 2 copper layers, 40.0 x 100.0 mm, 7 parts (0 on the bottom side), 6 nets.
