Crann-Data/speeduino-hardware/(commit log)

2025-05-28 kicad work
    [Fuel_Ignition.kicad_sch, connector.kicad_sch, inputs.kicad_sch, outputs.kicad_sch, power.kicad_sch, proto.kicad_sch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]
2025-05-28 split to 4v-mini
    [Bom-template-0.4.4b.xlsx, Fuel_Ignition.kicad_sch, Fuel_Ignition.sch, NA Miata 48 pin.fzz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]
2025-05-29 add replacement MOSFETS
    [Fuel_Ignition.kicad_sch, connector.kicad_sch, inputs.kicad_sch, outputs.kicad_sch, power.kicad_sch, proto.kicad_sch, v0.4.3d.kicad_pcb, v0.4.3d.kicad_sch]
