Crann-Data/speeduino-hardware/(notices)

Notices in the files:
v0.4-mini/SMD/Prior Versions/0.4.4b/v0.4.4b.kicad_pcb:
© Josh Stewart &
